EnviroDevelo/cems-platform/README.md

# CEMS Core Platform firmware

Shared firmware platform for the CEMS Supervisor instrument family (STM32H5, FreeRTOS,
lwIP, Riverdi EVE4). It runs the translated Valve Manager / Multiplexor program as a
PLC-style scan and provides the services around it.

- `docs/APP_INTEGRATION.md`: handover for the VM/MUX application build (what to supply, rules, open items)
- `docs/PLATFORM.md`: structure, task priorities, the scan contract, integration rules, decisions needed
- `docs/CUBEMX_SETUP.md`: bringing it up on the STM32H573I-DK in STM32CubeIDE
- `docs/MEMORY.md`: flash and RAM used by each module against the chip's limits (kept current)

## Host builds (Linux/macOS/WSL, gcc)

```
make test      # unit tests (with both FRAM memory maps; includes 400 random power cuts on the log)
make sim       # PC simulation of the demo application
make netsim    # the platform on real sockets: Modbus TCP on 1502, web on https://127.0.0.1:8443/
               # (FRAM and log flash are files: netsim_fram.bin, netsim_nor.bin)
               # (type "remote" / "local" on stdin to act as the touchscreen)
make rtos      # the real FreeRTOS task layer on the FreeRTOS POSIX port (needs EXT=path with FreeRTOS-Kernel)
make target    # compile-check for STM32H5 with arm-none-eabi-gcc (needs EXT, see port/stm32h5/check.mk)
tools/check_target.sh   # compile and link the target in six configurations; updates docs/MEMORY.md
```

Integration tests (with netsim built): `python3 tests/integration/net_test.py` (needs
pymodbus on PYTHONPATH), `python3 tests/integration/fw_test.py` (firmware update and
rollback), `python3 tests/integration/mail_test.py` (alarm email against a test mail
server; needs openssl), `python3 tests/integration/clock_test.py` (clock and SNTP), `python3 tests/integration/serial_test.py` (serial number tokens; needs Python cryptography),
`python3 tests/integration/soak_test.py [minutes]` (soak with memory and socket watch; needs pymodbus) and `python3 tests/integration/web_ui_test.py` (needs Python Playwright and
Chromium).

The application contract (`plat_app_t`) now includes `fw_safe` (may a firmware restart
happen now?) and `alarms`; see `app_demo/`.

Firmware update files: `tools/mkfwimage.py build.bin cems-x.y.z.cfw --version x.y.z`
(add `--key <pem>` to sign; key set-up in `docs/CUBEMX_SETUP.md` 3d).

Touchscreen previews: `UI_DUMP=build/ui ./build/tests` writes each screen's EVE command
list, and `python3 tools/eve_preview.py build/ui/*.eve` renders them to PNG (needs
Pillow). Current screens: `docs/ui/`.

The product build is the STM32CubeIDE project. These host builds are for testing
outside the IDE.
Third-party licences: `docs/THIRD_PARTY.md`. Schematic list and bring-up checks: `docs/HARDWARE.md`.
Screen colours, states, quality marks and wording for every product: `docs/UI_CONVENTIONS.md`.
