EnviroDevelo/cems-platform/docs/CORE_PCB.md

# Core PCB: design specification (draft)

Rev 0.1, 25 Oct 2026. The CEMS main ("core") board: the STM32H5, its memories, the two
Ethernet ports, and the RVT70 touch display plugged straight onto it by FFC (no separate
HMI board). The field I/O is on the separate I/O boards (`PLATFORM.md` 5k) and is not part
of this board. What the firmware needs from the board is in `HARDWARE.md` (H1-H11); this
document turns that into a schematic-ready plan. Items marked **(check)** must be confirmed
against the part's datasheet before layout.

## 1. Block diagram

```
 24 VDC in ─┬─ fuse, reverse-polarity FET, TVS, filter
            └─ buck 24→5 V (1.5 A) ─┬─ 5 V: display backlight (BLVDD, FFC)
                                    └─ buck 5→3.3 V (2 A) ─ MCU, PHY, W5500, memories, display logic

                    ┌──────────────── STM32H573VIT6 (LQFP100) ────────────────┐
 Client RJ45 ═ magnetics ═ LAN8742A ══ RMII ══ ETH MAC   │ lwIP: HTTPS, Modbus TCP, email, SNTP
 I/O RJ45    ═ magnetics ═ W5500 ═══ SPI4 ═══════════════│ I/O bus only (hardware sockets)
 RVT70 display (BT817) ═ 20-pin FFC ═ SPI3 ══════════════│ UI task
 W25Q128JV NOR (event + data log) ═ SPI2 ════════════════│ store task
 MB85RC1MT FRAM 128 KB (settings) ═ I2C1 ════════════════│ store task
 32.768 kHz LSE, CR2032 on VBAT (RTC) ═══════════════════│
 SWD + SWO, BOOT0, reset ════════════════════════════════│
                    └──────────────────────────────────────────────────────────┘
```

## 2. Two separate networks (decided, Gary 25 Oct)

| | Client port (RJ45 1) | I/O port (RJ45 2) |
|---|---|---|
| Purpose | The customer's plant network: PLC, SCADA, web browser, email, time server | Internal link to the I/O boards only |
| Silicon | MCU's own Ethernet MAC on RMII + LAN8742A PHY (as on the DK; firmware driver exists) | WIZnet W5500 (MAC, PHY and TCP/IP in hardware) on its own SPI |
| Stack | lwIP; every network service listens here | W5500 hardware sockets: 3 TCP (one per I/O board) + 1 UDP (discovery, port 50223); nothing listens |
| Addressing | Customer's subnet, DHCP or static | Fixed private subnet set at commissioning |
| MAC address | From the chip UID (D10) | From the chip UID with a different low byte |

No bridging or routing between the two is possible: the I/O traffic never enters lwIP, and
lwIP does not know the I/O port exists. The I/O boards' data reaches the client side only as
the core's own values (platform image → HTTPS and Modbus), never as forwarded packets.

**Hardware hardening of the client port** (security and industrial EMC):
- RJ45 with integrated magnetics (MagJack, Gary 25 Oct) rated 1500 Vrms isolation, Bob Smith
  termination to chassis through 1 nF / 2 kV.
- Low-capacitance ESD array on the PHY side of the magnetics (e.g. TI TPD4E05U06) **(check)**.
- RJ45 shield to the chassis-ground plane, which ties to logic ground only through
  1 MΩ ∥ 4.7 nF / 2 kV near the power input. The two Ethernet ports have separate chassis
  areas at their connectors.
- Nothing else on that connector: no PoE, no debug, no strap that changes the PHY mode.
- The I/O port gets the same protection. Its RJ45 is labelled **I/O ONLY** on the silkscreen
  and the enclosure, and should be a different LED colour or housing so that site
  technicians don't swap the cables. If they do, nothing is exposed: the W5500 has no
  listening sockets and the boards simply don't answer.

**Product lifecycle on the H573:** production units ship with debug closed, so SWD cannot
read the firmware or keys from a unit on site. The state and the recovery route are in
section 13.

## 3. MCU

STM32H573VIT6 (2 MB dual-bank flash, 640 KB RAM, crypto, LQFP100); the STM32H563VIT6 is
pin-compatible if hardware crypto and secure boot aren't wanted (H8). The firmware is
485 KB flash and 438 KB RAM with the application (`MEMORY.md`), so an image fits in one
bank as the bank-swap update needs. LQFP100 gives 82 I/O; this board uses about 45, so there
are spares for later without a bigger package, and it can be hand-reworked on prototypes.

Clocks: HSE crystal 25 MHz on PH0/PH1 (**check** it matches the DK so the CubeMX clock tree
for 250 MHz SYSCLK carries over unchanged); LSE 32.768 kHz on PC14/PC15 with load
capacitors per ST AN2867 (H1). The LAN8742A and the W5500 each have their own 25 MHz crystal, separate from the MCU's HSE (nothing in the MCU clock tree depends on them, and the W5500 SPI clock comes from SPI4). W5500 SPI runs at up to about 30 MHz: keep its traces short (under 50 mm) with a 33 Ω series resistor on SCK and MOSI at the MCU.

## 4. Pin map

Alternate functions are taken from ST's pin data for the STM32H573VI (the same data
CubeMX uses). The SPI, I2C and UART instances are the firmware's defaults where it has one, so
`main.h` needs the fewest overrides.

| Function | Pins (AF) | Firmware name / note |
|---|---|---|
| ETH RMII REF_CLK | PA1 (AF11) | 50 MHz from the LAN8742A (REFCLKO mode) |
| ETH MDIO / MDC | PA2 / PC1 (AF11) | PHY address 0 (strap) |
| ETH CRS_DV | PA7 (AF11) | |
| ETH RXD0 / RXD1 | PC4 / PC5 (AF11) | |
| ETH TX_EN | PA5 (AF11) | |
| ETH TXD0 / TXD1 | PB12 / PB15 (AF11) | |
| PHY nRST | PD11 (GPIO out, initial low → high) | `ETH_PHY_RST` |
| Display SPI3 SCK / MISO / MOSI | PC10 / PC11 / PC12 (AF6) | `hspi3`, the EVE default |
| Display CS | PA15 (GPIO out, initial high) | `EVE_CS` |
| Display PD_N | PD2 (GPIO out, initial high) | `EVE_PD` |
| Display INT_N | PD0 (EXTI0) | `EVE_INT` (routed; the driver polls today). The module has its own 47 kΩ pull-up |
| W5500 SPI4 SCK / MISO / MOSI | PE12 / PE13 / PE14 (AF5) | own bus, not shared (I/O timing) |
| W5500 SCSn | PE11 (GPIO out, initial high) | `W5500_CS` |
| W5500 INTn | PE9 (EXTI9, pull-up) | `W5500_INT` (routed; the driver polls today) |
| W5500 RSTn | PE10 (GPIO out, initial low → high) | `W5500_RST` |
| NOR SPI2 SCK / MISO / MOSI | PB13 / PB14 / PC3 (AF5) | `hspi2`, the NOR default |
| NOR CS | PD10 (GPIO out, initial high) | `NOR_CS`; WP# and HOLD# pulled up |
| FRAM I2C1 SCL / SDA | PB6 / PB7 (AF4) | `hi2c1`, the FRAM default; 2.2 kΩ pull-ups |
| Service UART USART1 TX / RX | PA9 / PA10 (AF7) | 3.3 V header for bench logging |
| SWD SWDIO / SWCLK / SWO | PA13 / PA14 / PB3 | 10-pin 1.27 mm Cortex debug header with NRST |
| BOOT0 | BOOT0 pin | 10 kΩ pull-down, test pad / jumper to 3.3 V (H9) |
| 24 V supply sense | PC0 (ADC1_INP10) | divider 100 k / 10 k; early power-fail warning, supply shown on the System screen |
| Status LEDs | PD12 (run), PD13 (fault) | `DO_01`, `DO_02` (labelled outputs, active high) |
| Hardware revision straps | PE7, PE8 | read once at boot |

Free for later: PA0, PA3, PA4, PA6, PA8, PA11, PA12, PB0-PB2, PB4, PB5, PB8-PB11, PC2,
PC6-PC9, PC13, PD1, PD3-PD7, PD8, PD9, PD14, PD15, PE0, PE2-PE6, PE15.

## 5. Power

| Rail | Source | Loads | Budget |
|---|---|---|---|
| 24 VDC in (18-32 V) | Pluggable terminal (+, 0 V, FE) | | about 0.3 A at 24 V |
| Input protection | Fuse 2 A time-lag (F1), series Schottky SS16 for reverse polarity (D1, 0.15 W at 0.3 A), bidirectional 3 kW TVS SMDJ33CA after it (D2), Y-capacitors to chassis (C16, C17), common-mode choke (L3), 47 µF bulk. Sized for IEC 61326-1 industrial, see `CORE_PCB_EMC.md` | | |
| 5 V | Buck, 60 V rated input: TI TPS54360 (U1, 3.5 A, about 600 kHz, catch diode B260A) | Display backlight BLVDD (FFC pins 17-18): 400 mA at full brightness; the 3.3 V buck about 450 mA | about 0.9 A |
| 3.3 V | Buck from 5 V: TI TLV62569 (U2, 2 A) | MCU about 120 mA, display logic 240 mA max (235 typ; datasheet), W5500 130 mA, LAN8742A 50 mA, NOR, FRAM | about 0.6 A |
| VBAT | CR2032 in a holder (H1) | RTC, backup registers | µA |
| VDDA / VREF+ | 3.3 V through a ferrite and 1 µF + 100 nF | ADC (supply sense) | |

The 60 V input rating is there because the TVS clamps at about 53 V during a surge; a 30 V
buck would not survive one. Display figures are from the RVT70HSBNWC00 V1.1A datasheet Rev 1.1 (27 Jul 2026):
VDD 3.0-3.6 V, 235 mA typ / 240 mA max (audio on at full volume); BLVDD 4.5-5.5 V (5.0 typ;
it still lights from 2.7 V but not at full brightness), 10 / 310 / 400 mA at minimum / 50 % /
100 % backlight. A 5 % 5 V rail is within range; keep the FFC's 5 V drop under 0.25 V. Brown-out: the MCU's BOR at the highest level
plus the supply-sense pin (H10). The core board drives no field outputs (H6 and H7 are on the I/O boards).

## 5a. Hold-up after the 24 V input fails

The firmware needs about 20 ms from the moment the supply crosses 16 V: up to 16 ms to see it
through its 16-sample average, plus finishing the current FRAM or NOR write (firmware thread,
26 Oct). The FRAM store and the log are already safe against a power cut at any byte
(`PLATFORM.md` 4, 5a); the hold-up only stops the last record being lost.

Energy available on the +24 V node between 16 V (detection) and 6 V (where the 5 V buck drops
out; the 3.3 V buck then runs on from the 5 V capacitors a little longer):
`E = ½ × C × (16² − 6²) = 110 × C` joules.

| Load at the moment of failure | Input power | C1 only (49 µF) | With C18 + C19 (1 mF) | Same, cold (-20 % C) |
|---|---|---|---|---|
| Full: backlight 100 %, both networks | about 5.3 W | 1 ms | 20 ms | 16 ms |
| Backlight off on power-fail | about 2.6 W | 2 ms | 42 ms | 34 ms |

So the board carries **two 470 µF 63 V electrolytics (C18, C19)** on the protected +24 V node
(63 V because the TVS clamps near 53 V during a surge), and the fuse goes to **2 A time-lag**
for their charging current at switch-on. **Firmware side (26 Oct):** "failing" trips on two raw readings in a row below 16 V
(2 ms, not the 16 ms average; the average still drives the display and the low/high alarms),
and the UI task turns the backlight off (REG_PWM_DUTY 0) as soon as `plat_power_failing()`
is true. That leaves about 2× margin, even cold.

Everything before 16 V is extra: from 24 V down to 16 V the same capacitors give another
28 ms at full load (`½ × C × (23.6² − 16²)` = 0.15 J), which the firmware doesn't count on.

## 6. Connectors

| Ref | Connector | Notes |
|---|---|---|
| J1 | Power in, 3-way pluggable terminal 5.08 mm | +24 V, 0 V, functional earth to chassis |
| J2 | Client RJ45, shielded, with LEDs | LAN8742A, see section 2 |
| J3 | I/O RJ45, shielded, with LEDs | W5500, labelled I/O ONLY |
| J4 | Display FFC, RiBUS, ZIF 20-pin, 0.5 mm pitch | See section 6a |
| J5 | SWD, 10-pin 1.27 mm Cortex debug | SWDIO, SWCLK, SWO, NRST, 3.3 V, GND |
| J6 | Service UART, 6-pin 2.54 mm (FTDI-cable order) | 3.3 V levels |
| BT1 | CR2032 holder | |
| SW1 | Reset button | |

## 6a. Display FFC (J4), from the RVT70 datasheet

ZIF 20-pin, 0.5 mm pitch. The display's connector is down-side contact; the core board's
connector contact side has to suit the cable the enclosure uses (same-side or opposite-side
FFC) **(check at mechanical layout)**.

| Pin | Display signal | Core board |
|---|---|---|
| 1 | VDD 3.3 V | 3.3 V rail, 10 µF + 100 nF at the connector |
| 2 | GND | GND |
| 3 | SPI_SCLK | PC10 (SPI3_SCK), 33 Ω series at the MCU |
| 4 | MISO / IO.1 | PC11 (SPI3_MISO) |
| 5 | MOSI / IO.0 | PC12 (SPI3_MOSI), 33 Ω series |
| 6 | CS | PA15 (`EVE_CS`) |
| 7 | INT (active low, 47 kΩ pull-up in the module) | PD0 (`EVE_INT`, EXTI0) |
| 8 | RST/PD (active low, 47 kΩ pull-up in the module) | PD2 (`EVE_PD`) |
| 9 | GPIO.0 | test pad, not connected |
| 10 | DISP_AUDIO | test pad, not connected (the module's own 1.5 W amplifier drives a speaker on its P2) |
| 11, 12 | GPIO.1/IO.2, GPIO.2/IO.3 (QSPI data 2, 3) | test pads; single SPI is enough (D24) |
| 13-16 | NC | not connected |
| 17, 18 | BLVDD | 5 V rail, 10 µF + 100 nF at the connector |
| 19, 20 | BLGND | GND |

The display's operating range is -20 to 70 °C (storage -30 to 80 °C): it, not the core
board's -40 to 85 °C parts, sets the instrument's rating.

## 7. Layout notes

- 4 layers: signal / solid ground / power / signal. RMII at 50 MHz and two 100 Ω Ethernet
  pairs need the unbroken ground under them.
- RMII traces short and length-matched (± 5 mm is plenty at 50 MHz), the REF_CLK
  point-to-point with a series resistor at the PHY. Keep RMII away from the SPI buses.
- Under each MagJack: no copper on the line side except chassis; the two ports' chassis
  areas don't touch.
- The W5500's SPI and the display's SPI are on opposite sides of the MCU (PE and PC/PD pins),
  which keeps the high-speed buses apart naturally.
- **Mounting (Gary, 25 Oct): DIN rail, behind the display.** The board sits in a DIN-rail
  enclosure on the rail inside the panel, and the display (179.96 × 119.00 × 13.72 mm,
  without the mounting metal frame) is in the panel door or front, linked by the RiBUS FFC.
  The outline follows the chosen DIN enclosure; the FFC connector goes on the board edge
  that faces the display, with a slot in the enclosure for the cable.
- FFC length: keep it as short as the panel allows, 150 mm or less. RiBUS has only three
  ground pins (2, 19, 20) and no ground between the SPI lines, so a long cable limits the SPI
  clock. The firmware's 30 MHz fast rate is to be proved on the real cable; it can drop to
  15 MHz with no visible effect on the screens. Two BLVDD conductors carry the 400 mA with
  well under 0.1 V drop at that length. If the door has to be further away, a small
  buffer/adapter board at the display is the fallback (not planned).
- Decoupling per ST's hardware getting-started application note for the STM32H5 **(check)**: 100 nF per VDD pin,
  4.7 µF bulk, and the VCAP capacitors at the values the datasheet gives.

## 8. Decisions and open questions

1. **Supply: 24 VDC (Gary, 25 Oct)**, 18-32 V range, the same as the I/O boards' field supply.
2. **Mounting: DIN rail, behind the display (Gary, 25 Oct)**; see section 7.
3. **No system-OK relay (Gary, 25 Oct):** the PLC's Modbus communication watchdog is
   enough to detect a core board that has stopped.
4. **No RS-485 on the core board (Gary, 25 Oct):** the second RJ45 replaces it. The
   firmware's RS-485 I/O link setting has no port on this board (`bsp_rs485()` returns NULL).
5. **Ethernet: RJ45s with integrated magnetics (Gary, 25 Oct)**, shielded, with LEDs,
   1500 Vrms, -40 to 85 °C.
6. **Enclosure (chosen 25 Oct, Gary can override):** see section 10.

## 9. BOM summary (main parts)

| Part | Function | Qty |
|---|---|---|
| STM32H573VIT6 (or H563VIT6) | MCU | 1 |
| LAN8742A-CZ-TR (-40 to 85 °C) | Client Ethernet PHY | 1 |
| W5500 (-40 to 85 °C) | I/O Ethernet controller | 1 |
| Würth 7499010121A (RJ45 with magnetics and LEDs) | J2, J3 | 2 |
| MB85RC1MT | 128 KB FRAM, settings | 1 |
| W25Q128JV | 16 MB NOR, event and data log | 1 |
| 25 MHz crystals | MCU HSE, PHY, W5500 | 3 |
| 32.768 kHz crystal | RTC | 1 |
| TPS54360DDA (60 V in, 3.5 A) | 24 → 5 V buck | 1 |
| TLV62569DBV | 5 → 3.3 V buck | 1 |
| SS16, SMDJ33CA, 2 A T fuse, Würth 744227 choke | Input protection | 1 each |
| 470 µF 63 V radial 12.5 mm, 105 °C | Hold-up (C18, C19) | 2 |
| TPD4E05U06 (or equal) | Ethernet ESD | 2 |
| Hirose FH12-20S-0.5SH(55) | Display FFC | 1 |
| CR2032 holder | VBAT | 1 |

## 10. Enclosure

The board goes in a DIN-rail electronics housing on the panel's rail. The two RJ45s, the
24 V terminal and the display's FFC exit all need openings, and the board has no field
wiring other than power. Shortlist:

| Housing | For | Against |
|---|---|---|
| **Phoenix Contact BC 107,6 (6 modules, 107.6 mm wide)**, chosen | Made for electronics boards: PCB guides at two levels, top covers for pluggable terminals and RJ45 openings, IP20 for a panel, widely stocked | Openings beyond the standard covers need machining |
| Camdenboss CNMB/6 (6 modules) | Low cost, quick to get | Plain covers: every RJ45 and the FFC slot must be machined |
| Phoenix Contact ICS 50 | Designed for front RJ45s and bus connectors | Dearer, larger than this board needs |

The board outline, the connector positions and the FFC exit follow the BC 107,6 PCB drawing.
**(check: the drawing could not be downloaded from here, so the outline is set at layout from
Phoenix Contact's data.)** The schematic doesn't depend on the enclosure.

## 11. Schematic

`hardware/core_pcb/` holds the KiCad 7 project: a root sheet and five sheets (power, MCU,
client Ethernet, I/O Ethernet, memories and display), 145 parts, and a PDF of all sheets
(`cems_core.pdf`) for review without KiCad. The schematic is generated from
`hardware/core_pcb/tools/design.py`, the single description of the circuit, by
`gen_schematic.py`. Each connected pin carries a net label and each unused pin a no-connect
flag. `check_netlist.py` then checks KiCad's own exported netlist against `design.py`, pin by
pin, along with each part's footprint and value. `bom.csv` is the grouped bill of materials.
Values marked CHECK in the sheet notes (buck compensation, crystal load capacitors, the
Ethernet line terminations, the FRAM pinout, the FFC contact side) must be confirmed against
their datasheets before layout.

## 12. What the firmware reads from the board (CIP-01.3, CIP-07.3)

**Hardware revision straps, PE7 and PE8.** Read once at boot, as inputs with the internal
pull-ups and pull-downs off; each pin has a 10 kΩ to ground (R23, R24) and a 10 kΩ to 3.3 V
footprint (R25, R26), and a revision fits one or the other.

| PE8 | PE7 | `hw_rev` | Board |
|---|---|---|---|
| 0 | 0 | 0 | Rev A (this design, rev 0.1 schematic) |
| 0 | 1 | 1 | Rev B |
| 1 | 0 | 2 | Rev C |
| 1 | 1 | 3 | Rev D |

`hw_rev = (PE8 << 1) | PE7`. The firmware reports it with the firmware version (`/api/info`,
System screen) and can refuse an image built for another revision. A fifth revision needs a
third strap (PE15 is free and next to them).

**24 V supply sense, PC0 (ADC1_INP10).** R9 100 kΩ over R10 8.2 kΩ, both 1 %, with C13 100 nF:

- `V24 = V_PC0 × (100 + 8.2) / 8.2 = 13.20 × V_PC0`. With the 12-bit ADC and VREF+ = VDDA:
  `V24 = raw × VDDA / 4095 × 13.20`. Take VDDA from the VREFINT calibration value
  (VDDA = 3.3 V × VREFINT_CAL / VREFINT reading), not the nominal 3.3 V, since the 3.3 V rail
  is only ±2 %.
- Full scale is 43.5 V; 24 V reads about 1.82 V (raw about 2260).
- The sense point is after the reverse-polarity diode D1, so it reads about 0.4 V below the
  terminal voltage at full load. Add 0.4 V for display, or report "supply (after protection)".
- Accuracy: about ±3 % with VREFINT correction (resistor tolerances and the ADC).
- Source impedance 7.6 kΩ, but C13 holds the node, so any sampling time works. The node's
  time constant is 0.76 ms: average 16 samples per reading; it is a supervision value, not a
  fast one.
- Suggested thresholds: below 19 V supply low (warning); below 16 V supply failing (log it
  and stop writes that are not power-safe); above 30 V supply high. The bucks run down to
  about 6 V at the input, so the board keeps working through the whole range.
- A surge can briefly lift PC0 to about 4 V; the 100 kΩ limits the injected current to well
  under the pin's 5 mA. Readings in the 100 µs after such an event are not trusted (the
  average covers it).

## 13. Debug lock and recovery (agreed with the firmware thread, 26 Oct; CIP-04.4, CIP-20.4)

Based on ST's STM32H5 product-state model (RM0481 "product life cycle" and debug
authentication). **(check: confirm the state names and what each regression erases in
RM0481 before the first production unit is closed.)**

| Stage | Product state | Debug | Recovery |
|---|---|---|---|
| Development, bench, DK | Open | Full SWD | SWD (J5), BOOT0 jumper (JP1) for the ST bootloader |
| Production units | **Closed, with debug authentication provisioned** | Off: SWD can't read flash, RAM or keys | Authorised regression over SWD (below) |
| Not used | Locked | Off for good | None: a unit with both banks bad would be scrap |

- **Normal updates never need SWD:** the network update writes the free bank, test-boots it
  and rolls back by itself (`PLATFORM.md` 5b). Recovery is only for a unit whose both
  banks are unusable, which the update design prevents.
- **Recovery route:** a technician with the company's debug-authentication credential
  (certificate on the H573; a password on the H563) opens the housing, connects J5, and runs
  a regression with ST's tools. That erases the user flash and returns the chip to Open; the
  factory image is then programmed and the unit closed again. FRAM and the NOR log are
  separate chips and are kept. The serial number (D25), hw_rev, calibration, every setting
  and the HTTPS key all live in FRAM (firmware thread, 26 Oct), so the unit keeps its
  identity and certificate fingerprint and needs no developer token afterwards.
- **Confirmed by the firmware thread (26 Oct)**, with one bench check: the network update
  flips SWAP_BANK from the application, which the H5 allows when Closed. The first Closed DK
  must show an update and a rollback working. Secure boot will keep this route, with no
  Locked state.
- **Hardware for this:** J5 (SWD with NRST) fitted on every unit, inside the housing, not
  reachable without opening it; JP1 BOOT0 footprint fitted, no jumper in production (the
  bootloader is not a route on a closed unit); BOOT0 pulled down by R20.
- The credential is held like the firmware signing key: not in the repository, two people
  hold it.
