EnviroDevelo/cems-platform/docs/MEMORY.md

# Memory budget (decision D18)

Generated by `tools/mem_report.py` from the linker map of the fullest target build
(I2C FRAM, SPI NOR log flash, EVE display, lwIP, every service). Re-run it after every
module, and before choosing hardware. Last run: 2026-10-22.

## Totals

| Resource | Used | Limit | Used % | Free |
|---|---|---|---|---|
| Flash (one bank: the image limit with dual-bank updates) | 391.1 KB | 1016.0 KB | 38 % | 624.9 KB |
| RAM (STM32H573/H563, 640 KB) | 391.7 KB | 640.0 KB | 61 % | 248.3 KB |

## By module (KB)

| Module | Flash | RAM |
|---|---|---|
| Scan engine, queue, watchdog, diag | 18.9 | 0.1 |
| Parameter table | 9.4 | 25.7 |
| Parameter store (FRAM) | 5.3 | 57.2 |
| Event log / data logger | 14.5 | 6.8 |
| Alarm manager | 4.9 | 2.9 |
| Alarm email (SMTP client) | 6.2 | 2.2 |
| Clock + SNTP | 1.7 | 0.1 |
| Firmware update, signatures, serial | 6.0 | 1.6 |
| I/O boards (RS-485 master) | 6.5 | 0.4 |
| Modbus TCP | 6.0 | 17.5 |
| Web server + page + logins | 41.9 | 72.9 |
| HTTPS (tls.c + mbedTLS) | 96.3 | 46.9 |
| Touch UI + EVE driver | 52.1 | 2.5 |
| Task layer (FreeRTOS glue) | 2.6 | 54.8 |
| Board support (BSP) | 0.9 | 0.7 |
| lwIP + Ethernet driver | 54.4 | 48.5 |
| FreeRTOS kernel + heap | 10.0 | 48.8 |
| ST HAL + startup | 21.2 | 0.0 |
| Application | 2.1 | 0.2 |
| C library | 27.6 | 0.8 |
| Other | 2.5 | 0.0 |
| Main stack (interrupts, start-up) | 0.0 | 1.0 |

## With the VM/MUX application (app_vmmux)

The same build with the real application linked in (`make target APP=...`).

| Resource | Used | Limit | Used % | Free |
|---|---|---|---|---|
| Flash | 485.3 KB | 1016.0 KB | 48 % | 530.7 KB |
| RAM | 438.2 KB | 640.0 KB | 68 % | 201.8 KB |

The application itself: 83.5 KB of flash, 46.1 KB of RAM (its tags, timers and tables).

RAM includes every task stack (inside "Task layer"), the FreeRTOS heap (48 KB, in
"FreeRTOS kernel + heap", used by lwIP), and TLS's own fixed 44 KB pool (inside "HTTPS"),
shared by the web server and the alarm-email client one at a time: measured peaks 28 KB
(web), 32 KB (mail server with an RSA-2048 key), 38 KB (RSA-4096). Alarm email added
about 31 KB of flash (TLS client, RSA, SHA-384/512 for the server's certificate, SMTP) and
11 KB of RAM (the larger pool, the client context and buffers). The 128 KB FRAM map (D6)
added about 60 KB of RAM: the store's working copy of a 40 KB settings slot and the web
server's buffer, which holds a whole backup file for restore.

## Still to come (estimates, update when built)

| Item | Flash | RAM | Note |
|---|---|---|---|
| Application alarm table (the ~50 alarms of 70_alarm_map) | ~2.5 | 0 | 24 bytes of constants each; RAM per alarm is already reserved (96 slots) |

## Other non-volatile memory

| Store | Size | Used | Note |
|---|---|---|---|
| FRAM (MB85RC1MT, 128 KB; D6, Gary 20 Oct) | 128 KB | user image: the VM/MUX application's 13.4 KB including the platform settings, of 40 KB per copy (34 %); factory 4 KB; log pointer, boot record, HTTPS key record and firmware update history 848 B | the 32 KB breakout (MB85RC256V) still fits the application (90 % per copy) with PLAT_FRAM_SIZE=32768u; the driver refuses a part smaller than the build's map |
| Log flash (W25Q128, 16 MB) | 16 MB | ring buffer, always "full" by design | events ~16,000; data 45 days at 10 channels / 60 s |
