EnviroDevelo/cems-platform/docs/web_alarm_actions.png

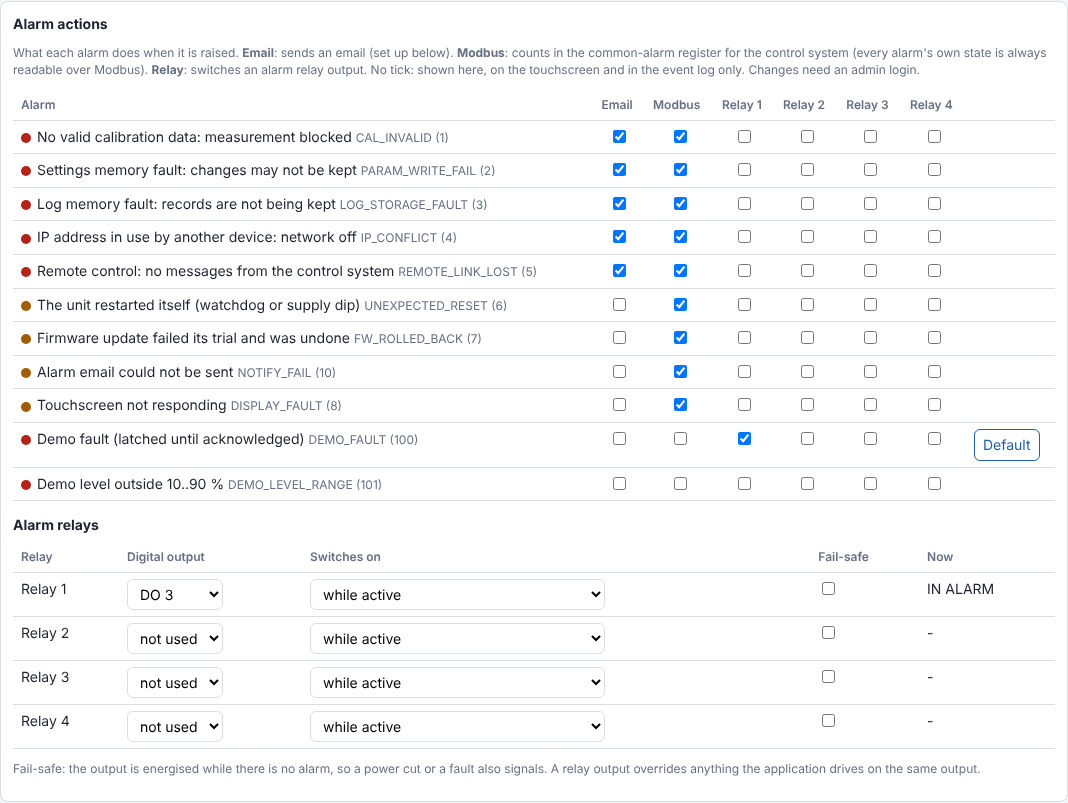
docs/web_alarm_actions.png
