EnviroDevelo/cems-platform/docs/web_clock.png

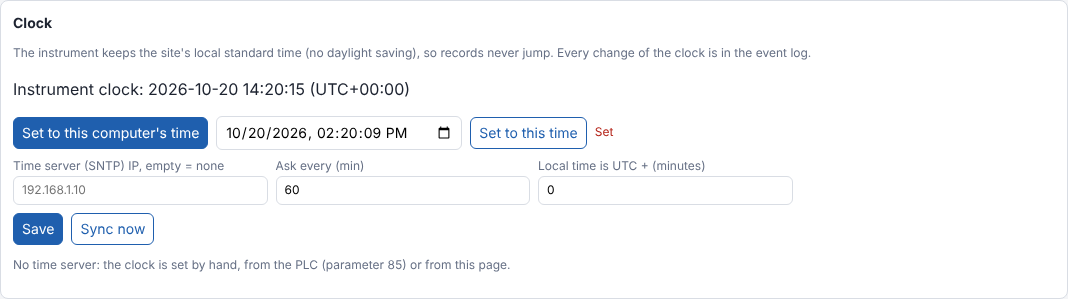
docs/web_clock.png
