EnviroDevelo/cems-platform/docs/web_firmware.png

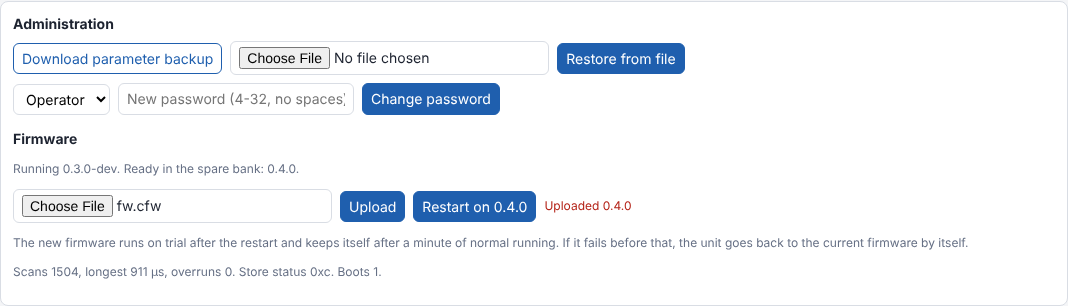
docs/web_firmware.png
