EnviroDevelo/cems-platform/docs/web_iob.png

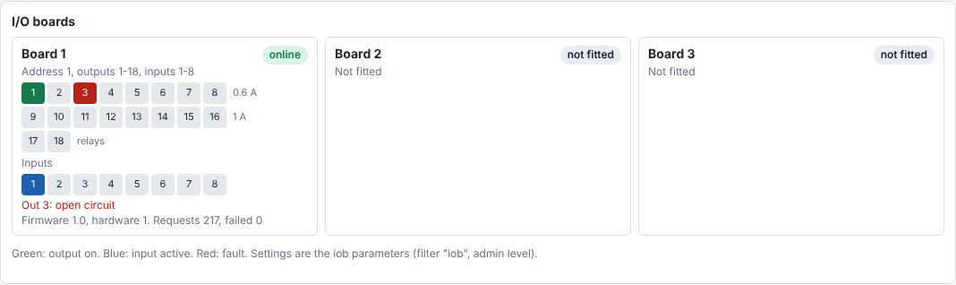
docs/web_iob.png
