EnviroDevelo/cems-platform/docs/web_mail.png

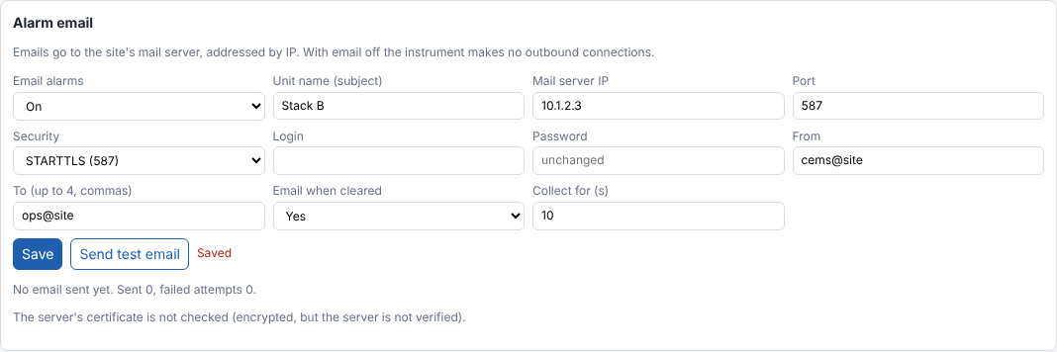
docs/web_mail.png
