EnviroDevelo/cems-platform/docs/web_ui.png

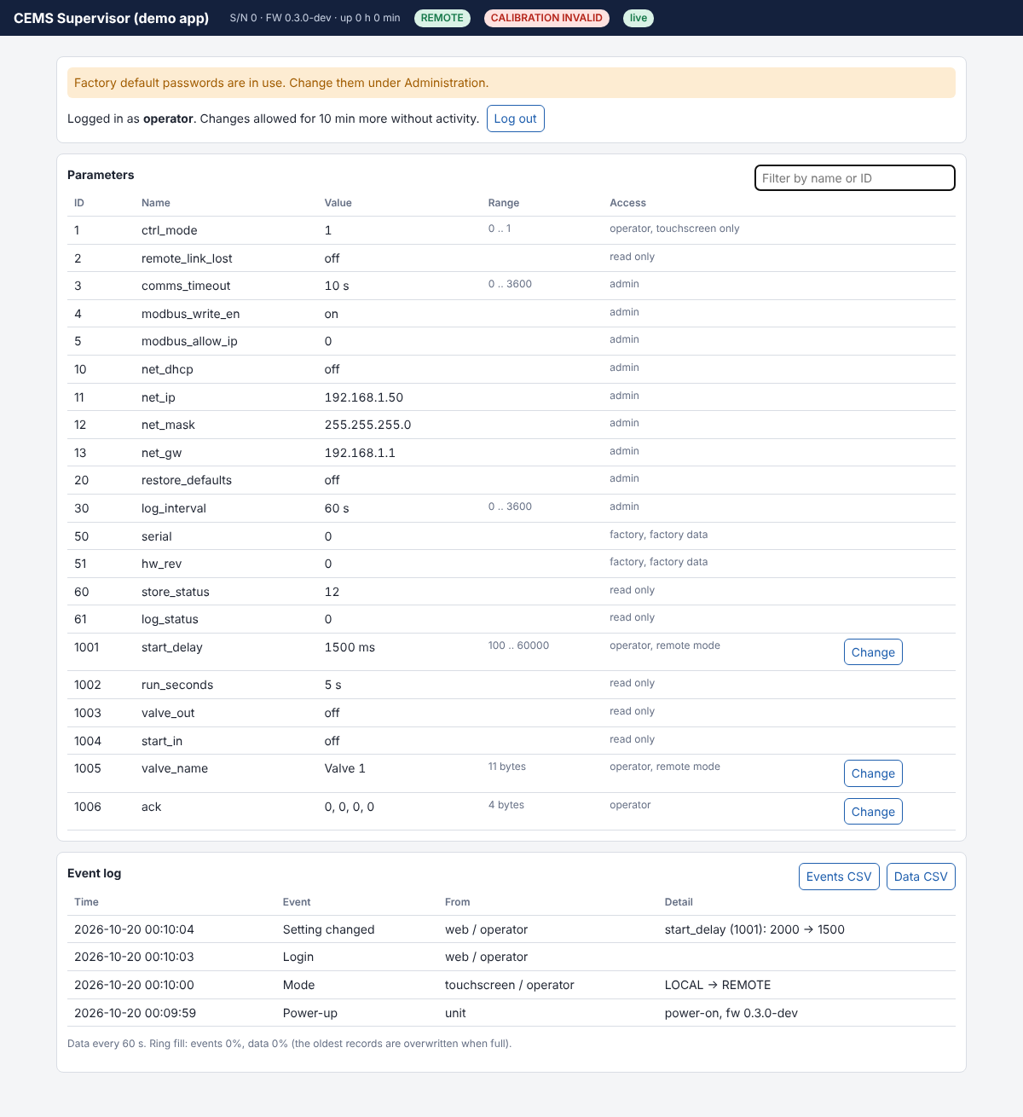
docs/web_ui.png
