EnviroDevelo/cems-platform/docs/web_ui_connection_lost.png

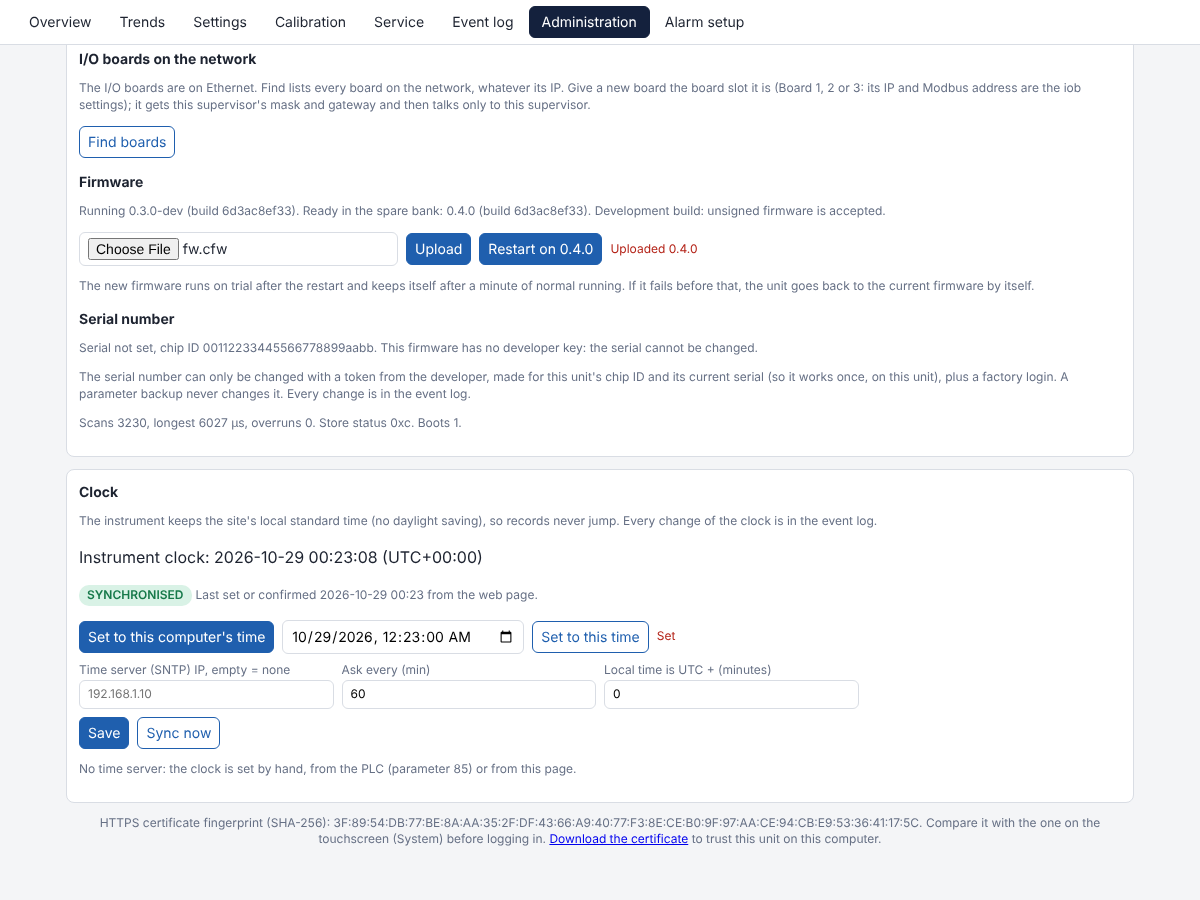
docs/web_ui_connection_lost.png
