EnviroDevelo/cems-platform/docs/web_iob_commission.png

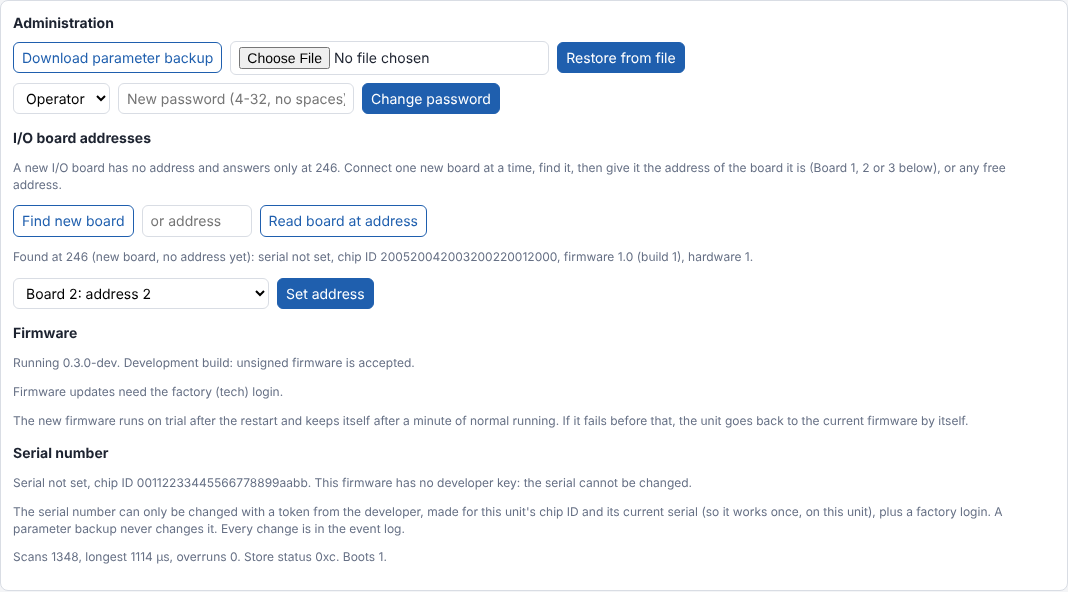
docs/web_iob_commission.png
