EnviroDevelo/cems-platform/hardware/core_pcb/power.kicad_sch

## KiCad design hardware/core_pcb/power.kicad_sch (2026-10-26)

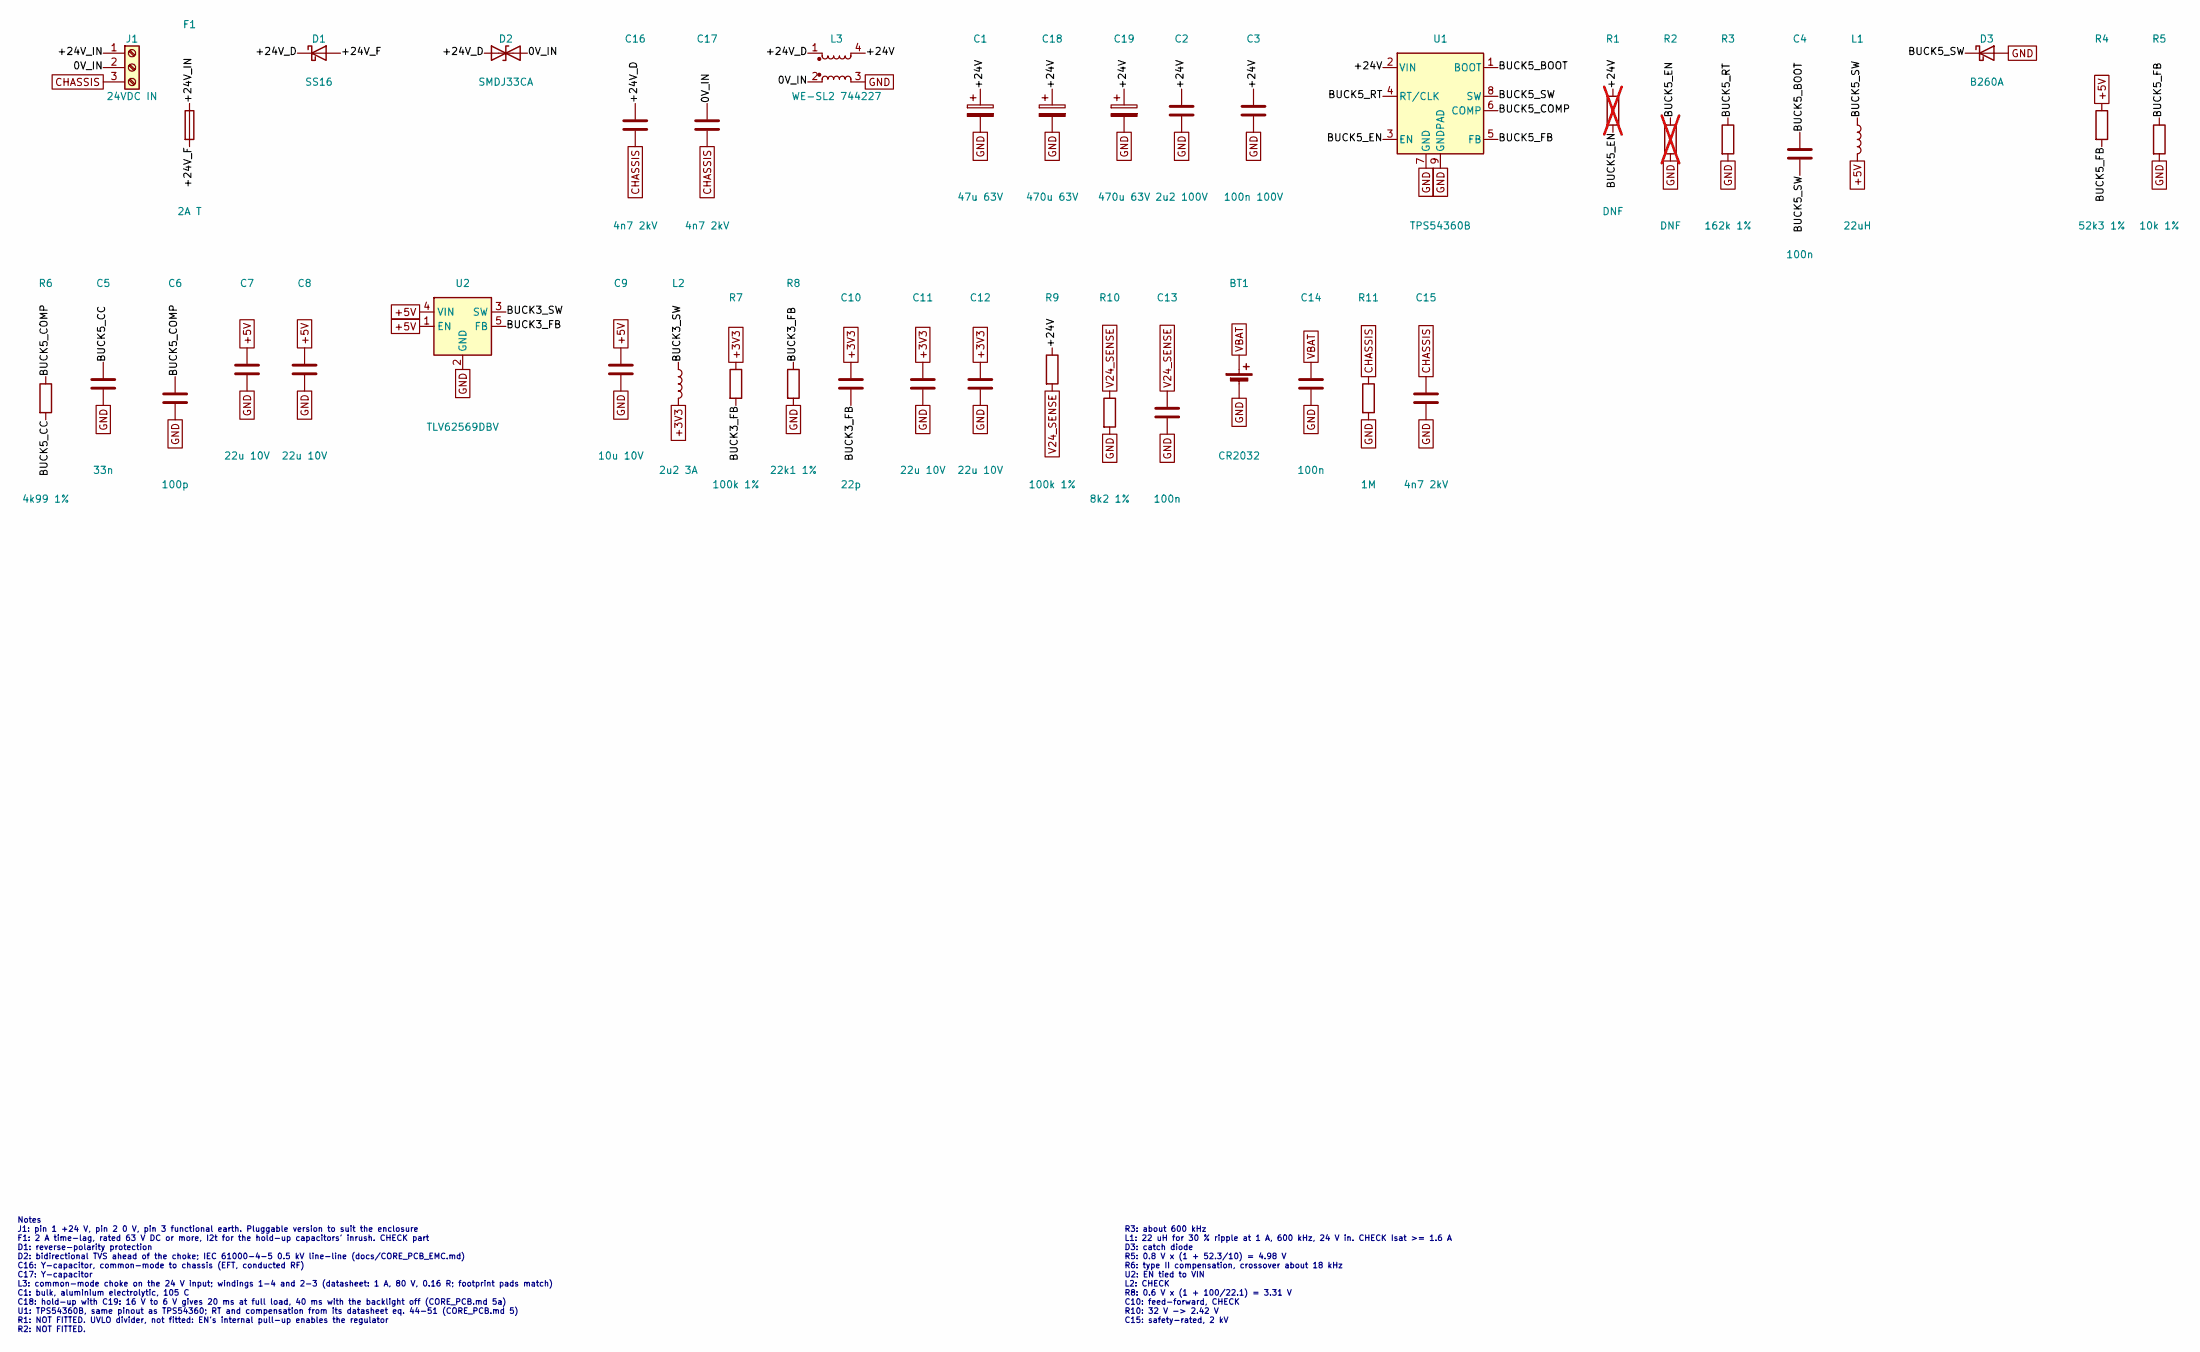
[picture p9: schematic power.kicad_sch]

Parts:
BT1: CR2032; BatteryHolder_Keystone_3034_1x20mm; MPN Keystone 3034 holder + CR2032
C1: 47u 63V; CP_Elec_8x10; MPN 47u 63V
C2: 2u2 100V; C_1210_3225Metric; MPN 2u2 100V
C3: 100n 100V; C_0603_1608Metric; MPN 100n 100V
C4, C13, C14: 100n; C_0603_1608Metric; MPN 100n
C5: 33n; C_0603_1608Metric; MPN 33n
C6: 100p; C_0603_1608Metric; MPN 100p
C7, C8: 22u 10V; C_1210_3225Metric; MPN 22u 10V
C9: 10u 10V; C_0805_2012Metric; MPN 10u 10V
C10: 22p; C_0603_1608Metric; MPN 22p
C11, C12: 22u 10V; C_1206_3216Metric; MPN 22u 10V
C15, C16, C17: 4n7 2kV; C_1812_4532Metric; MPN 4n7 2kV
C18, C19: 470u 63V; CP_Radial_D12.5mm_P5.00mm; MPN 470 uF 63 V, 105 C, low ESR, 12.5 mm ra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
D1: SS16; D_SMA; MPN SS16 (60 V, 1 A)
D2: SMDJ33CA; D_SMC; MPN SMDJ33CA (3 kW)
D3: B260A; D_SMA; MPN B260A-13 (60 V, 2 A)
F1: 2A T; Fuse_1206_3216Metric; MPN 2A T
J1: 24VDC IN; TerminalBlock_Phoenix_MKDS-1,5-3-5.08_1x03_P5.08mm_Horizont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; MPN 24VDC IN
L1: 22uH; L_Bourns_SRN6045TA; MPN Bourns SRN6045TA-220M
L2: 2u2 3A; L_Wuerth_MAPI-4030; MPN Wurth 74438357022 (MAPI 4030, 2.2 uH)
L3: WE-SL2 744227; L_CommonMode_Wuerth_WE-SL2; MPN Wurth 744227
R1, R2: DNF; R_0603_1608Metric; MPN DNF; not fitted
R3: 162k 1%; R_0603_1608Metric; MPN 162k 1%
R4: 52k3 1%; R_0603_1608Metric; MPN 52k3 1%
R5: 10k 1%; R_0603_1608Metric; MPN 10k 1%
R6: 4k99 1%; R_0603_1608Metric; MPN 4k99 1%
R7, R9: 100k 1%; R_0603_1608Metric; MPN 100k 1%
R8: 22k1 1%; R_0603_1608Metric; MPN 22k1 1%
R10: 8k2 1%; R_0603_1608Metric; MPN 8k2 1%
R11: 1M; R_1206_3216Metric; MPN 1M
U1: TPS54360B; TI_SO-PowerPAD-8_ThermalVias; MPN TPS54360BDDAR
U2: TLV62569DBV; SOT-23-5; MPN TLV62569DBVR

Connections:
0V_IN: C17.1, D2.2 (A2), J1.2, L3.2
+3V3: C10.1, C11.1, C12.1, L2.2, R7.1
+5V: C7.1, C8.1, C9.1, L1.2, R4.1, U2.1 (EN), U2.4 (VIN)
+24V: C1.1, C2.1, C3.1, C18.1, C19.1, L3.4, R1.1, R9.1, U1.2 (VIN)
+24V_D: C16.1, D1.1 (K), D2.1 (A1), L3.1
+24V_F: D1.2 (A), F1.2
+24V_IN: F1.1, J1.1
BUCK3_FB: C10.2, R7.2, R8.1, U2.5 (FB)
BUCK3_SW: L2.1, U2.3 (SW)
BUCK5_BOOT: C4.1, U1.1 (BOOT)
BUCK5_CC: C5.1, R6.2
BUCK5_COMP: C6.1, R6.1, U1.6 (COMP)
BUCK5_EN: R1.2, R2.1, U1.3 (EN)
BUCK5_FB: R4.2, R5.1, U1.5 (FB)
BUCK5_RT: R3.1, U1.4 (RT/CLK)
BUCK5_SW: C4.2, D3.1 (K), L1.1, U1.8 (SW)
CHASSIS: C15.1, C16.2, C17.2, J1.3, R11.1
GND: BT1.2 (-), C1.2, C2.2, C3.2, C5.2, C6.2, C7.2, C8.2, C9.2, C11.2, C12.2, C13.2, C14.2, C15.2, C18.2, C19.2, D3.2 (A), L3.3, R2.2, R3.2, R5.2, R8.2, R10.2, R11.2, U1.7 (GND), U1.9 (GNDPAD), U2.2 (GND)
V24_SENSE: C13.1, R9.2, R10.1
VBAT: BT1.1 (+), C14.1

Notes on the sheet:
Notes J1: pin 1 +24 V, pin 2 0 V, pin 3 functional earth. Pluggable version to suit the enclosure F1: 2 A time-lag, rated 63 V DC or more, I2t for the hold-up capacitors' inrush. CHECK part D1: reverse-polarity protection D2: bidirectional TVS ahead of the choke; IEC 61000-4-5 0.5 kV line-line (doc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
R3: about 600 kHz L1: 22 uH for 30 % ripple at 1 A, 600 kHz, 24 V in. CHECK Isat >= 1.6 A D3: catch diode R5: 0.8 V x (1 + 52.3/10) = 4.98 V R6: type II compensation, crossover about 18 kHz U2: EN tied to VIN L2: CHECK R8: 0.6 V x (1 + 100/22.1) = 3.31 V C10: feed-forward, CHECK R10: 32 V -> 2.42 V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
