EnviroDevelo/cems-platform/platform/include/plat_alarm.h

/* plat_alarm.h - the alarm manager (design spec "Alarms"; Analysis 70_Alarms_Logging
 * section 8, findings K1-K12).
 *
 * One table of alarm definitions and one state per alarm. Producers only report a
 * condition; the manager owns the delays, the latch, the acknowledge and the state,
 * so the old program's two layers (source bits plus the panel's own alarm table,
 * whose texts drifted onto the wrong alarms: K1, K2) become one.
 *
 * IDs: 1..99 platform (ALARM_ID_* below), 100..255 application.
 *
 * States (ISA-18.2 style):
 *   normal            condition absent, nothing to acknowledge
 *   active, unacked   condition present (after the on-delay), not yet acknowledged
 *   active, acked     condition present, acknowledged
 *   cleared, unacked  condition gone (after the off-delay) before anyone acknowledged:
 *                     stays in the list until acknowledged, so a short alarm is not missed
 * AL_LATCH: an active alarm stays active after its condition goes until acknowledged
 *   (the old FlowValidationAlarm). AL_NO_ACK: a status alarm, shown while active,
 *   never waits for an acknowledge (digital stop, analyser not OK: K8).
 * Acknowledge never changes a condition, never clears a source and never re-sends
 * anything (K7, N3): it only moves the alarm's state. One alarm by ID, or all.
 *
 * Every raise, clear and acknowledge goes to the event log with the source and login
 * level (K11, K12). Optional per-alarm parameters: an enable (false suppresses the
 * alarm, e.g. a range alarm switched off; retained, so it survives a power cut: K4),
 * an editable description (stored with the settings, so it cannot land on another
 * alarm: K1, K2) and an on-delay in seconds (valve feedback settling time: N11).
 *
 * Threading
 *   alarm_set(), alarm_set_range()   any task (a byte store); normally the scan logic
 *   alarm_scan()                     scan task, once per scan (plat_sys pre_logic)
 *   alarm_ack()                      scan task (param_apply calls it for PARAM_ID_ALARM_ACK);
 *                                    other tasks post that parameter instead
 *   alarm_list(), alarm_summary(),
 *   alarm_get()                      any task: a consistent copy
 */
#ifndef PLAT_ALARM_H
#define PLAT_ALARM_H
#include <stdint.h>
#include <stdbool.h>
#include <stddef.h>
#include "plat_io.h"

#ifndef PLAT_ALARM_MAX
#define PLAT_ALARM_MAX 96u           /* platform + application definitions */
#endif
#define ALARM_ID_MAX      255u
#define ALARM_ID_APP_FIRST 100u
#define ALARM_ACK_ALL     0xFFFFu    /* PARAM_ID_ALARM_ACK value: acknowledge every alarm */
#define ALARM_BIT_WORDS   16u        /* PARAM_ID_ALARM_*_BITS: bit (id % 16) of word (id / 16) */

/* severities: the colour in the lists and the header */
enum { AL_SEV_STATUS = 0, AL_SEV_WARNING = 1, AL_SEV_ALARM = 2, AL_SEV_FAULT = 3 };

/* Actions (routes), per alarm. Each alarm has a default in its definition; the user
 * changes it with parameter 46 (one byte per alarm ID): bit 7 set = configured (bits
 * 0..6 apply), bit 7 clear = use the definition's default. 0x80 = do nothing. */
#define AR_EMAIL    0x01u   /* send an email (raise; clear too if mail_on_clear) */
#define AR_MODBUS   0x02u   /* counted in the Modbus common-alarm word (parameter 45) */
#define AR_RELAY(k) ((uint8_t)(0x04u << (k)))   /* drive alarm relay k (0..3) */
#define AR_SET      0x80u
#define ALARM_RELAYS 4u
/* relay modes (parameter 48) */
enum { AR_MODE_ACTIVE = 0,      /* on while any routed alarm is active */
       AR_MODE_UNACKED = 1,     /* on while any routed alarm waits for an acknowledge (a horn: ack silences it) */
       AR_MODE_ACTIVE_OR_UNACKED = 2 };  /* on until every routed alarm is both cleared and acknowledged (a lamp) */
/* parameter 45 bits */
#define ACOM_MB_ACTIVE   0x0001u  /* a Modbus-routed alarm is active */
#define ACOM_MB_UNACKED  0x0002u  /* a Modbus-routed alarm waits for an acknowledge */
#define ACOM_ANY_ACTIVE  0x0004u
#define ACOM_ANY_UNACKED 0x0008u
#define ACOM_RELAY(k)    ((uint16_t)(0x0100u << (k)))   /* relay k is in alarm (before inversion) */

/* flags */
#define AL_LATCH   0x01u   /* stays active until acknowledged, even if the condition goes */
#define AL_NO_ACK  0x02u   /* status alarm: no acknowledge, leaves the list when it clears */
#define AL_NOTIFY  0x04u   /* passed to alarm_on_change (notification: email, relay; Stage 8) */

typedef struct {
    uint16_t    id;            /* 1..99 platform, 100..255 application */
    uint8_t     severity;      /* AL_SEV_* */
    uint8_t     flags;         /* AL_* */
    uint32_t    on_delay_ms;   /* condition must last this long to raise (0 = at once) */
    uint32_t    off_delay_ms;  /* and be gone this long to clear */
    const char *name;          /* event log and JSON key: [A-Z0-9_], up to 22 characters */
    const char *text;          /* description shown when no text parameter is given */
    uint16_t    text_param;    /* PT_TEXT / PT_TEXT16 parameter with an editable description (0 = none) */
    uint16_t    enable_param;  /* bool parameter: false suppresses the alarm (0 = always enabled) */
    uint16_t    delay_param;   /* integer parameter, s: replaces on_delay_ms (0 = none) */
    uint8_t     route;         /* default actions: AR_EMAIL | AR_MODBUS | AR_RELAY(k) (0 = none) */
} alarm_def_t;

/* ---------------- platform alarms ---------------- */
enum {
    ALARM_ID_CAL_INVALID       = 1,   /* no valid factory (calibration) data: measurement blocked */
    ALARM_ID_PARAM_WRITE_FAIL  = 2,   /* settings could not be written to the FRAM */
    ALARM_ID_LOG_STORAGE_FAULT = 3,   /* log flash erase/write/read-back failed */
    ALARM_ID_IP_CONFLICT       = 4,   /* another device answers at our static IP address */
    ALARM_ID_REMOTE_LINK_LOST  = 5,   /* remote control and no remote traffic for the timeout */
    ALARM_ID_UNEXPECTED_RESET  = 6,   /* the watchdog or a brown-out restarted the unit */
    ALARM_ID_FW_ROLLED_BACK    = 7,   /* a firmware update failed its trial and was undone */
    ALARM_ID_DISPLAY_FAULT     = 8,   /* the touchscreen stopped responding */
    ALARM_ID_NOTIFY_FAIL       = 10,  /* an alarm email could not be sent (after retries) */
    ALARM_ID_RESOURCE_LOW      = 11,  /* memory running low (plat_health.h) */
    ALARM_ID_IOB_LOST          = 12,  /* an enabled I/O board does not answer on RS-485 (iobus.h) */
    ALARM_ID_IOB_CONFIG        = 13,  /* an I/O board is the wrong type, or its channel settings conflict */
    ALARM_ID_IOB_OUT_FAULT     = 14,  /* an I/O board output: open circuit, short, overheating, no field supply */
    ALARM_ID_IOB_IN_FAULT      = 15,  /* an I/O board input: wire break or input chip fault */
    ALARM_ID_IOB_SUPPLY        = 16,  /* an I/O board's field 24 V supply is missing */
    ALARM_ID_IOB_NODE_RESET    = 17,  /* an I/O board was restarted by its watchdog */
    ALARM_ID_IOB_TEMP_FAULT    = 18,  /* an I/O board temperature input: open, short, out of range, converter fault */
};

/* A copy of one alarm, for lists. */
typedef struct {
    uint16_t id;
    uint8_t  severity, flags;
    bool     active, unacked, cond, enabled;
    uint32_t t_raise;          /* s since 1970 when raised (0 if the clock was not set) */
    uint32_t up_raise;         /* uptime s when raised */
    const char *name;
    char     text[64];         /* the description (UTF-8) */
} alarm_view_t;

typedef struct {
    uint16_t active;           /* alarms active (including acknowledged ones) */
    uint16_t unacked;          /* alarms waiting for an acknowledge (active or cleared) */
    uint16_t shown;            /* entries in the list: active or unacked */
    int8_t   worst;            /* highest severity among the shown entries, -1 if none */
    bool     worst_unacked;    /* that severity has an unacknowledged entry */
} alarm_summary_t;

/* Build the table from the platform alarms plus the application's. Returns 0, or
 * the first bad ID (duplicate, 0, > 255, an application ID below 100, a missing
 * parameter or a full table). reset_cause (bsp_reset_cause_t) raises
 * UNEXPECTED_RESET after a watchdog or brown-out reset. Call after param_init. */
int  alarm_init(const alarm_def_t *app_defs, size_t n_app, uint8_t reset_cause);

/* Producers. Unknown IDs are ignored. alarm_set_range: the condition is "value
 * outside lo..hi"; once raised it stays until the value is back inside by the
 * deadband (no chatter on a limit: K5). NaN keeps the previous condition. */
void alarm_set(uint16_t id, bool cond);
void alarm_set_range(uint16_t id, float value, float lo, float hi, float deadband);

void alarm_scan(uint32_t now_ms);     /* scan task: platform conditions, delays, states, events */
void alarm_io_out(plat_io_out_t *out); /* scan task, after the application's outputs: the alarm relays */
uint8_t alarm_route(uint16_t id);     /* the actions in force for an alarm (AR_* without AR_SET) */
uint8_t alarm_relays(void);           /* bit k = relay k in alarm (before inversion) */

/* Email (mail.c provides it; weak no-op otherwise): one alarm transition to send. */
void plat_alarm_email(const alarm_def_t *d, uint8_t what, uint32_t t_unix, uint32_t up_s);

/* Acknowledge one alarm or ALARM_ACK_ALL. 0 done (or nothing to acknowledge),
 * -1 unknown ID. Scan task (via PARAM_ID_ALARM_ACK). */
int  alarm_ack(uint16_t id, uint8_t src, uint8_t level);

/* Readers (any task). The entries that are active or unacked, most urgent first
 * (unacked active, then acked active, then cleared unacked; higher severity first;
 * newest first). alarm_next walks them one at a time (start with *pos = 0; false at
 * the end); alarm_list copies up to max after skipping skip (a page). */
bool   alarm_next(uint64_t *pos, alarm_view_t *out);
size_t alarm_list(alarm_view_t *out, size_t skip, size_t max);
bool   alarm_get(uint16_t id, alarm_view_t *out);
void   alarm_summary(alarm_summary_t *s);
bool   alarm_active(uint16_t id);          /* e.g. to mark a logged value FLAG */
size_t alarm_count(void);                  /* definitions */
const alarm_def_t *alarm_def_at(size_t i);
const char *alarm_sev_name(uint8_t sev);

/* Notification hook (Stage 8: email, relay, nothing). Called in the scan task on
 * every transition of an AL_NOTIFY alarm. what: 1 raised, 2 cleared, 3 acknowledged. */
enum { ALARM_TR_RAISE = 1, ALARM_TR_CLEAR = 2, ALARM_TR_ACK = 3 };
extern void (*alarm_on_change)(const alarm_def_t *d, uint8_t what);

/* For tests: forget every state (definitions stay). */
void alarm_reset_for_test(void);

#endif
