EnviroDevelo/cems-platform/platform/include/plat_clock.h

/* plat_clock.h - setting the instrument's clock (decision D22).
 *
 * The RTC keeps the site's local standard time (no daylight saving: a CEMS record
 * must not jump an hour twice a year). parameter 82 time_utc_offset (minutes) says how
 * far that is from UTC; it is used by the SNTP client and in email Date headers.
 *
 * Ways to set it, every one logged (LOG_EV_TIME_SET: old -> new, who, from where):
 *   touchscreen  System > Set clock (admin)
 *   web          "Set to this computer's time" or a typed time (admin)
 *   Modbus       write local seconds-since-1970 to parameter 85 clock_set (operator,
 *                REMOTE mode, as every PLC write): how a DAHS keeps the clock in step
 *   SNTP         from the site's time server (parameter 83 sntp_server, 0 = off),
 *                every sntp_interval minutes; only steps the clock when it is 2 s or
 *                more out, so the log is not filled with tiny corrections
 *
 * Threading: plat_clock_request() from any task; the scan task applies it (it owns
 * the RTC snapshot), so a set never tears a scan. */
#ifndef PLAT_CLOCK_H
#define PLAT_CLOCK_H
#include <stdint.h>
#include <stdbool.h>

#define PLAT_CLOCK_MIN_UNIX 1577836800u   /* 2020-01-01: anything earlier is refused */
#define PLAT_CLOCK_MAX_UNIX 4102444799u   /* 2099-12-31 23:59:59 */

/* Ask for the clock to be set to local_unix (local standard time as seconds since
 * 1970). how: a short word for the event log ("web", "sntp" ...). 0 = queued,
 * -1 out of range. */
int  plat_clock_request(uint32_t local_unix, uint8_t src, uint8_t level, const char *how);
void plat_clock_scan(void);                 /* scan task, pre_logic: applies a request */
bool plat_clock_now(uint32_t *local_unix);  /* any task: the clock as of the last scan; false = never set */
int32_t plat_clock_utc_offset_s(void);      /* parameter 82, in seconds */

/* SNTP client (platform/net/sntp.c), net task. */
typedef struct {
    uint32_t last_ok_ms;      /* uptime of the last good answer, 0 = none yet */
    int32_t  last_diff_s;     /* the clock was this far behind the server then (s; + = clock slow) */
    uint8_t  stratum;
    uint32_t tries, fails, steps;
    char     error[40];       /* the last failure, in words; "" if the last try worked */
} sntp_status_t;
void sntp_service(uint32_t now_ms);         /* net task, every few hundred ms; does a query when due */
void sntp_request_now(void);                /* query at the next service (web "Sync now") */
void sntp_status(sntp_status_t *s);
void sntp_reset_for_test(void);
extern uint16_t sntp_port;                  /* 123; tests use another */

#endif
