EnviroDevelo/cems-platform/platform/include/plat_sha256.h

/* plat_sha256.h - SHA-256 (FIPS 180-4), for password hashes. */
#ifndef PLAT_SHA256_H
#define PLAT_SHA256_H
#include <stdint.h>
#include <stddef.h>
typedef struct { uint32_t h[8]; uint64_t len; uint8_t buf[64]; size_t n; } sha256_t;
void sha256_init(sha256_t *s);
void sha256_update(sha256_t *s, const void *data, size_t len);
void sha256_final(sha256_t *s, uint8_t out[32]);
#endif
