EnviroDevelo/cems-platform/tests/integration/mail_test.py

#!/usr/bin/env python3
"""Alarm email end to end: build/netsim against a small SMTP server written here
(plain, STARTTLS and implicit TLS; RSA and ECDSA certificates made with openssl).

Checks: configuration over HTTPS, the test email, an alarm routed to email (and its
clear), batching, AUTH PLAIN over TLS, login refused without TLS, the certificate
fingerprint and pinning (a changed certificate is refused), retries then NOTIFY_FAIL,
the password never readable (web, backup file), the per-alarm action switch.

    python3 tests/integration/mail_test.py"""
import base64, hashlib, http.cookiejar, json, os, socket, ssl, subprocess, sys, tempfile, threading, time
import urllib.parse, urllib.request

ROOT = os.path.dirname(os.path.dirname(os.path.dirname(os.path.abspath(__file__))))
MB, WEB = 15602, 18602
BASE = f"https://127.0.0.1:{WEB}"
CTX = ssl._create_unverified_context()
TMP = tempfile.mkdtemp()
passed = failed = 0


def check(cond, what):
    global passed, failed
    if cond:
        passed += 1; print("  ok  ", what)
    else:
        failed += 1; print("  FAIL:", what)


def make_cert(name, kind):
    key, crt = os.path.join(TMP, name + ".key"), os.path.join(TMP, name + ".crt")
    alg = ["-newkey", "rsa:" + os.environ.get("RSA_BITS", "2048")] if kind == "rsa" else ["-newkey", "ec", "-pkeyopt", "ec_paramgen_curve:P-256"]
    subprocess.run(["openssl", "req", "-x509", "-nodes", *alg, "-keyout", key, "-out", crt, "-days", "30",
                    "-subj", "/CN=mail.site.local", "-sha384"], check=True, capture_output=True)
    der = ssl.PEM_cert_to_DER_cert(open(crt).read())
    fp = ":".join(f"{b:02X}" for b in hashlib.sha256(der).digest())
    return key, crt, fp


class Smtp:
    """mode: plain | starttls | tls. Records every message; can refuse logins."""
    def __init__(self, port, mode, cert=None, user="cems", password="Secr3t pw"):
        self.mode, self.cert, self.user, self.password = mode, cert, user, password
        self.msgs, self.auths, self.sessions = [], [], 0
        self.ls = socket.socket(); self.ls.setsockopt(socket.SOL_SOCKET, socket.SO_REUSEADDR, 1)
        self.ls.bind(("127.0.0.1", port)); self.ls.listen(5)
        threading.Thread(target=self.run, daemon=True).start()

    def ctx(self):
        c = ssl.SSLContext(ssl.PROTOCOL_TLS_SERVER); c.load_cert_chain(self.cert[1], self.cert[0]); return c

    def run(self):
        while True:
            try:
                c, _ = self.ls.accept()
            except OSError:
                return
            threading.Thread(target=self.session, args=(c,), daemon=True).start()

    def session(self, c):
        self.sessions += 1
        try:
            if self.mode == "tls":
                c = self.ctx().wrap_socket(c, server_side=True)
            f = c.makefile("rb")
            def send(s): c.sendall(s.encode() + b"\r\n")
            send("220 mail.site.local ESMTP test")
            secure = self.mode == "tls"
            mail = {"rcpt": []}
            while True:
                ln = f.readline()
                if not ln:
                    return
                ln = ln.decode().rstrip("\r\n")
                cmd = ln.split(" ")[0].upper()
                if cmd == "EHLO":
                    caps = ["250-mail.site.local"]
                    if self.mode == "starttls" and not secure:
                        caps.append("250-STARTTLS")
                    if secure:
                        caps.append("250-AUTH LOGIN PLAIN")
                    caps.append("250 8BITMIME")
                    c.sendall(("\r\n".join(caps) + "\r\n").encode())
                elif cmd == "STARTTLS":
                    send("220 go ahead")
                    c = self.ctx().wrap_socket(c, server_side=True); f = c.makefile("rb"); secure = True
                elif cmd == "AUTH":
                    parts = ln.split(" ")
                    if parts[1].upper() == "PLAIN":
                        _, u, p = base64.b64decode(parts[2]).decode().split("\0")
                        self.auths.append((u, p))
                        send("235 ok" if (u, p) == (self.user, self.password) else "535 5.7.8 Authentication credentials invalid")
                    else:
                        send("504 not here")
                elif cmd == "MAIL":
                    mail = {"from": ln[10:].strip("<>"), "rcpt": []}; send("250 ok")
                elif cmd == "RCPT":
                    mail["rcpt"].append(ln[8:].strip("<>")); send("250 ok")
                elif cmd == "DATA":
                    send("354 end with .")
                    body = []
                    while True:
                        l2 = f.readline().decode("utf-8")
                        if l2 in (".\r\n", ""):
                            break
                        body.append(l2[1:] if l2.startswith("..") else l2)
                    mail["data"] = "".join(body); mail["secure"] = secure
                    self.msgs.append(mail); send("250 queued")
                elif cmd == "QUIT":
                    send("221 bye"); return
                else:
                    send("502 ?")
        except Exception as e:
            print("   smtp server:", e)
        finally:
            try: c.close()
            except Exception: pass

    def close(self):
        self.ls.close()
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
