EnviroDevelo/cems-platform/(commit log)

2026-10-19 Core platform: scan engine, task skeleton, watchdog supervisor
    - PLC-style scan engine running the translated VM/MUX program: measured
    g_dt_ms, first-scan bit, per-scan RTC snapshot (UniLogic weekday),
    frozen input image, outputs default off, bounded external-write queue,
    seqlock snapshot publishing, execution statistics
    - Single definition of the UniLogic system tags (ul_system.h)
    - FreeRTOS task set with design-spec priorities, static allocation,
    weak service bodies, stack/malloc/assert hooks
    - Task monitor gating the IWDG; fault record kept across warm resets
    - BSP interface with PC simulation and STM32H5 HAL implementations
    - Host unit tests (161 checks), PC sim, FreeRTOS POSIX r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
2026-10-19 Shared parameter table, arbitration and FRAM parameter store
    - param: one validated table for touchscreen, web and Modbus (ID, level,
    local/remote mode, type, range, interlock), platform entries (mode,
    network, Modbus write enable, serial, store status), remote-link
    watchdog, per-scan shadow for readers
    - param_store: PF_PERSIST parameters plus retained blocks; factory and
    user regions with A/B copies, CRC-32 and sequence; records by ID with
    migration hook; fail-safe calibration-invalid handling; restore
    defaults keeps factory data; backup export/import with integrity checks
    - NVM interface with RAM simulation (power-cut injection) and SPI FRAM
    driver; store task; scan system h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
2026-10-19 I2C FRAM driver and 32 KB memory map for the MB85RC256V
    - nvm_fram_i2c.c: MB85RC series over HAL I2C, DMA (default), interrupt
    or polling, polling before the scheduler; A16 handling for 128 KB parts
    - Memory map chosen by PLAT_FRAM_SIZE: 32 KB default (dev part, 16%
    headroom against the old project's 342 retained tags), 128 KB option;
    static checks that the map does not overlap
    - bsp_param_nvm tries I2C, then SPI, then the RAM stand-in
    - Tests run with both maps; target link checked in five configurations
    Claude-Session: https://claude.ai/code/session_01Gwvd8bu485TQsBajzHm6x6
2026-10-19 Parameter blocks, batch writes, Modbus engine and Modbus TCP framing/server
    - Parameter table: text, UTF-16 text, raw bytes and arrays as entries, with
    reader copies, a block write queue, all-or-nothing batches, persistence
    - Scan applies every queued write before the logic (no split batches)
    - Modbus engine: FC 1/2/3/4/5/6/15/16/43-14 over a map of table entries,
    word/byte order, decimal scaling, strict all-or-nothing writes
    - Modbus TCP: MBAP framing with partial/pipelined frames, socket server
    with client limit, eviction of the longest-silent client, IP filter
    - 1,401 host checks
    Claude-Session: https://claude.ai/code/session_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
2026-10-19 Modbus TCP, web interface and lwIP networking
    - Modbus engine over the parameter table (all shapes of the old slave map),
    MBAP framing, socket server with client limit, eviction and IP filter
    - Web: JSON API, page with live polling and connection-lost banner, logins
    with salted SHA-256 passwords in FRAM, sessions with write re-auth,
    CSRF header, backup/restore through a store-task mailbox
    - Parameter blocks, all-or-nothing batches, scan applies the whole queue
    - lwIP 2.2.1 on FreeRTOS: lwipopts, ST H5 Ethernet driver ported to native
    FreeRTOS (SLA0044), net task with per-unit MAC and live address changes
    - Tests: 2,191 unit checks; netsim on real sockets with pymodbus and HTTP
    (49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
2026-10-19 Event log and data logger on serial NOR, CSV export, web event list
    - plat_log: two rings (events, data) of CRC-protected 64-byte slots, erase-ahead
    overwrite-oldest, FRAM write pointer with flash rebuild, interval means with
    quality codes, schema records, clock-change and parameter-change events
    - nor.h with RAM simulation (power-cut injection) and a JEDEC SPI NOR driver
    - log_csv: streaming CSV for events and data; /api/log/* endpoints; login,
    password, restore and logout events from the web API
    - platform parameters 30 (log_interval) and 61 (log_status)
    - tests: unit (incl. random power-cut fuzz), netsim integration, browser
    C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
2026-10-19 Firmware update foundation: streamed upload, bank swap, trial boot, rollback
    - fw_update: .cfw image header (product, version, SHA-256, signature hook),
    streaming upload into the free bank with read-back verification, staged image
    in a trailer sector, FRAM boot record (pending/trial/rolled back), automatic
    confirm after a healthy trial, rollback on a reset during the trial
    - STM32H5 dual-bank flash driver (SWAP_BANK) and a RAM simulation
    - HTTP: streamed POST /api/fw/upload, GET /api/fw, POST /api/fw/activate;
    firmware section on the admin page with upload progress
    - tools/mkfwimage.py; unit tests, end-to-end netsim test with swap/reset,
    browser test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
2026-10-19 EVE BT817 display driver and the touch UI
    - eve: SPI framing, BT817 start-up with the Riverdi RVT70 timing, co-processor
    command lists (text, buttons, keys, numbers, progress, rectangles, lines),
    touch tags, co-processor fault recovery, buffer overflow guard
    - ui: home tiles and local/remote control, paged settings with the reason a row
    can't be changed, numeric/IP/on-off/text entry through the parameter table,
    log in with lockout and idle logout, events, system (firmware restart with
    confirmation, network, unit, storage, brightness), confirm dialogs, dimming
    - UI task with display retry; firmware trial health includes the display;
    STM32H5 SPI transport; app supplies home tiles;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
2026-10-19 Duplicate-address check (ARP probe), IP CONFLICT alarm; HTTPS and remote-access design (D11, D17)
    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
2026-10-19 HTTPS (D11): unit key and self-signed certificate, TLS 1.2 server, redirect; memory record (D18)
    - tls: P-256 key made at first start, kept in FRAM META (two copies, never in
    backups); deterministic self-signed certificate with the unit's IP; session
    tickets; fixed 36 KB mbedTLS pool; fingerprint on the touchscreen and web page;
    certificate download to trust the unit; new-key event
    - web server: HTTPS on 443, port 80 redirect only (parameter 6), refused
    uploads drained so clients get the answer
    - mbedTLS 3.6.7 LTS subset vendored in third_party/mbedtls (Apache-2.0)
    - tools/mem_report.py and docs/MEMORY.md: flash/RAM by module from the linker
    map, run by tools/check_target.sh
    - test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
2026-10-19 Firmware image signing (D14): ECDSA P-256, key tool, dev-build notice
    - fw_sig.c verifies r||s over SHA-256(header 0..83) with mbedTLS; fw_pubkey.c
    (generated by tools/fwkey.py) holds the product key; with a key, unsigned or
    wrongly signed images are refused
    - mkfwimage.py --key signs the header as sent (flags=1); --check --pub verifies
    - /api/fw signing_required; web page and System screen show the dev-build notice
    - tests: unit (keys made in test: accept, unsigned/other-key/edited refused),
    fw_test signed flow via netsim CEMS_FW_PUBKEY (30 checks)
    - *.pem ignored so the private key can't be committed; docs and MEMORY.md updated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
2026-10-19 Alarm actions per alarm (email, Modbus, relays, nothing) and alarm email
    - per-alarm actions (parameter 46, user choice over the application default):
    email, Modbus common-alarm word (45), alarm relays 1-4 on any digital output
    with active / horn / lamp modes and fail-safe (47-49), via a scan io_out hook
    - alarm email: SMTP to the site mail server by IP, STARTTLS / TLS / plain,
    login only over TLS, server certificate pinning (test email shows the
    fingerprint, trust stores it), batching, retries, NOTIFY_FAIL, event log;
    runs in the web task and shares its TLS context and pool (44 KB)
    - mbedTLS: TLS client, RSA, SHA-384/512, base64, keep peer certificate
    - PF_SECRET / RF_SECRET: the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
2026-10-20 Clock: set from touchscreen, web, PLC or the site's SNTP server; every change logged once
    - plat_clock: requests from any task applied by the scan (bsp_rtc_write on H5,
    host, netsim, rtos sim); range 2020-2099; weekday computed; logged with source
    and level; the logger no longer reports the same step as an unexplained jump
    - parameters 82 UTC offset, 83 SNTP server, 84 interval, 85 clock_set (momentary,
    PLC/DAHS), 86 clock_unix (RO)
    - SNTP v4 client: echo check, unsynchronised servers ignored, steps only when
    2 s out, retry after 60 s; runs in the net task (netsim: own thread)
    - web: Clock section (set to this computer, typed time, SNTP set-up, Sync now);
    touchscreen: System > Set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
2026-10-20 Own touchscreen fonts (° ² ³ µ ...), health monitoring, soak test
    Fonts (D24): tools/mkfont.py renders DejaVu Sans at the ROM font sizes as EVE L4
    fonts with ASCII and 31 symbols in codes 1..31; kept zlib-compressed in the
    firmware (24 KB), inflated into RAM_G at start-up (CMD_INFLATE) and checked with
    CMD_MEMCRC; a font that fails falls back to the ROM font. The UI encodes UTF-8
    for them (eve_font_encode). Simulator: CMD_INFLATE with its own zlib decoder,
    CMD_MEMCRC answered in the FIFO, RAM_G; preview tool draws the symbols.
    Health: the supervisor samples heap (free, worst) and every task's stack margin
    every 5 s; /api/info health, System screen, alarm 11 RESOURCE_LOW (latched).
    tests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
2026-10-20 docs: HARDWARE.md schematic list (RTC VBAT + LSE added) and DK bring-up checks; FRAM size deferred
    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
2026-10-22 I/O boards on RS-485 (D27): Modbus RTU master, channel image to 64 with fault bits, alarms, events, screens; simulated I/O node
    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
2026-10-22 Memory record with the I/O bus and app_vmmux; I/O boards as their own module in the report
    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
2026-10-22 I/O boards: input filter default 8 ms (as the old panel and the design spec)
    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
2026-10-22 I/O boards: the node holds its outputs for a set time (default 5 min, up to 10) when the link goes quiet; 'not responding' stays at 1 s
    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
2026-10-22 I/O boards: latched comms fault at both ends (IOB_LOST latched; node COMMS_LOST cleared only after acknowledge); every input change shown to the master
    iobus.h: STATUS bit 8 COMMS_LOST, FAULT_CLEAR bits (1 events, 2 comms), INPUTS change hold.
    iobus.c: IOB_LOST also raised by a board's COMMS_LOST; FAULT_CLEAR bit 1 sent only once
    IOB_LOST is acknowledged; events and a fault line. plat_alarm.c: IOB_LOST AL_LATCH.
    iob_node_sim.c: the same behaviour as the node firmware. Tests: t_comms_latch, t_input_pulse.
    Claude-Session: https://claude.ai/code/session_01NqyuUAraePKPtYTAPTmWUU
2026-10-22 iobus.h: I/O board address handshake (registers 40-51, iob_cfg_check), commissioning address 246, serial number registers 52-59; simulated node follows; t_node_cfg
    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
2026-10-22 iobus.h: the I/O board address change is one guarded FC16 write of 40-42 (key 0xA55A, address, complement); handshake removed; simulated node follows
    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
2026-10-24 I/O boards: address setting 1..245 (246 and 247 are the commissioning and USB addresses)
    iobN_address allowed 1..247, but a node answers on RS-485 only at 1..IOB_ADDR_MAX;
    246 is where a board without an address answers (reads and the address change only)
    and 247 is its USB port. A board set to either never ran. The parameter range and
    bad_settings() now stop at IOB_ADDR_MAX; t_wrong_type_and_conflicts checks both.
    Claude-Session: https://claude.ai/code/session_018PtUXH3akFPqQfzHC3CnCM
2026-10-24 I/O boards: find a new board and set its address from the web page
    A new I/O board answers only at 246 until it has an address. Administration ->
    I/O board addresses (admin login) finds it, shows its serial, chip ID and
    firmware, and gives it an address with the guarded FC16 of 40-42 (FW-61). The
    master refuses an address something already answers at, and reads the board
    back at the new address before reporting success; the change is logged.
    - iobus.c: iob_cm_find / iob_cm_assign, done by the bus task between cycles
    - http_api.c: POST /api/iob/find, POST /api/iob/assign, GET /api/iob/commission
    - web/index.html (+ web_page.c regenerated)
    - tests: t_commission, the HTTP routes, iob_test.py c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
2026-10-24 I/O boards on Ethernet: Modbus TCP master and discovery commissioning (D27 revised)
    The I/O bus master can now run over Ethernet (parameter 102 iob_link, default Ethernet)
    with RS-485 kept as an option. Frames stay RTU inside the master; iob_net.c converts to
    and from Modbus TCP (unit id = board address), so every rule of the register map holds.
    Each board has an IP setting (iobN_ip). A UDP discovery protocol (FIND/HERE/SET, port
    50223) lists the boards on the network and gives a board its IP and address; a board
    that has a supervisor IP accepts settings and Modbus TCP only from that supervisor.
    Tests run the bus suite on both links against simulated boards, plus the codec,
    Ethernet commiss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
2026-10-24 I/O boards on Ethernet: socket transport (Modbus TCP client, UDP discovery)
    iob_tcp.c gives the master its Ethernet port over plat_net.h sockets (POSIX on the PC,
    lwIP on the H5): one connection per board, opened on first use, a connect timeout,
    late replies dropped by transaction id, a connection that sends garbage closed and
    reopened. Discovery broadcasts to IOB_DISC_PORT from an ephemeral port; the boards
    answer to the broadcast address at that port.
    Wired into plat_start (FreeRTOS) and netsim (simulated boards on a simulated network,
    or real boards with CEMS_IOB_TCP=1). Tested over the loopback against a simulated board
    in a child process. lwIP pools and the iobus stack grown to fit.
    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
2026-10-24 I/O boards on Ethernet: commissioning from the HTTPS page
    GET /api/iob/net lists the boards found on the network (identity, MAC, IP settings,
    which board slot they match); POST /api/iob/net/find broadcasts a search and
    POST /api/iob/net/set gives a board a slot's IP and Modbus address with the
    supervisor's own fixed IP, mask and gateway (refused with DHCP on). The admin page shows
    the Ethernet panel or the RS-485 address panel, whichever link is in use.
    netsim gets 'node n new' (a replacement board with no IP and no address); the
    integration test commissions a board over Ethernet from the page, then switches the
    link to RS-485 and runs the address commissioning there (43 checks).
    Co-Author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
2026-10-24 netsim: CEMS_IOB_TCP_HOST, to run against a virtual I/O board on the PC
    Connects every board connection to one address (io-node's build/vnode_net on 127.0.0.1),
    since the PC has none of the plant's addresses. Used by io-node's net_e2e.py.
    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
2026-10-24 Docs: I/O boards on Ethernet (D27 revised 24 Oct)
    D27, PLATFORM.md 5k (the link, IP commissioning, settings), HARDWARE.md H11 (Ethernet
    replaces RS-485; RS-485 optional), CUBEMX_SETUP 3g and APP_INTEGRATION.
    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
2026-10-25 I/O boards: temperature inputs and pump PWM (register map 2)
    From the review of the legacy dryer slave. The master accepts map 1
    and map 2 boards; on map 2 it writes the PWM with the outputs, reads
    the larger status block, reads temperatures every 500 ms when a sensor
    is configured, sends sensor type/NTC/PWM settings on change, applies
    per-channel offset and span, and fills the platform's RTD channels.
    - iobus.h/iobus.c: map 2 registers, types, states, iob_temp_cal.
    - New alarm IOB_TEMP_FAULT (18) and status bit; parameters 160+16k.
    - Web: temperature table and pump line per board, admin "Set to..."
    zero against a reference (POST /api/iob/temp/zero).
    - Simulated node implements map 2; tes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
2026-10-25 CPU fault handlers (D4) and docs catch-up for the Ethernet I/O boards
    HardFault, MemManage, BusFault and UsageFault now go to
    port/stm32h5/fault_stm32h5.c: outputs to the safe state, the stacked PC and
    LR plus CFSR, HFSR and the faulting address into plat_diag, then a reset.
    The next boot shows the fault as "bus @0801A2C4" on the System screen, the
    web page and the event log's power-up entry; /api/info last_fault gains
    arg, lr, cfsr, hfsr and addr. A stack-limit fault is named "stack" with no
    PC, since its frame is not usable.
    Docs: D4 marked built; CubeMX must not generate the four fault handlers;
    the iobus task row, the memory report label and APP_INTEGRATION's D6 line
    brought up to date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
2026-10-25 HARDWARE.md: second RJ45 for the Ethernet I/O board via a 3-port switch IC (proposed)
    Claude-Session: https://claude.ai/code/session_014onnq3eRiDkqdAB6fKiRDW
2026-10-25 Touchscreen I/O boards screen: board IP on Ethernet, temperatures and pump
    Since D27 the boards are reached by IP; the screen showed only the Modbus
    address. Each board card now shows its IP and address on Ethernet (or
    "RS-485, address N"), the channel ranges on the Outputs/Inputs headings,
    the configured temperature channels (calibrated, as on the web page; a
    faulty channel says "fault" with the reason in the fault lines) and the
    pump duty and speed (register map 2). Integer formatting, no float printf.
    Docs: H4 records the display plugged straight onto the core PCB (Gary,
    25 Oct), the RiBUS pinout with the 5 V backlight supply, and the ILI2132A
    touch controller; screenshots regenerated.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
2026-10-25 Generous stack and heap sizes; name the task on a stack-limit fault
    Gary, 25 Oct: stack overflows on earlier DK prototypes, so size for
    headroom from the start. Task stacks doubled (85 KB in all, each still
    overridable), idle and timer stacks doubled, FreeRTOS heap 48 -> 64 KB,
    main stack 1 -> 8 KB and C heap 0.5 -> 4 KB in the linker settings
    (CUBEMX_SETUP.md section 1, and the link check uses the same values).
    RAM: 73 % for the platform, about 80 % with the VM/MUX application.
    The CM33 port gives every task a PSPLIM, so an overflow is a UsageFault
    with STKOF before anything is corrupted; the fault handler now records the
    running task, shown as "stk scan".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
2026-10-25 HARDWARE.md: W5500 I/O port pin and socket notes from the firmware thread
    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
2026-10-25 Web page: I/O board card shows the board's IP, as the touchscreen does
    "192.168.1.61, address 1" on Ethernet, "RS-485, address 1" otherwise,
    "No IP set (iobN_ip)" when blank; from iob_link and iobN_ip in the value
    poll. iob_test.py checks the card text.
    Claude-Session: https://claude.ai/code/session_01EABSPFqJyWXzEHYMFCKdZS
2026-10-25 Web page: fits a phone's width
    Below 640 px the parameter and alarm lists stack into cards, wide tables
    scroll inside their own section, and the certificate fingerprint wraps,
    so the page no longer scrolls sideways (it was 600 px wide in a 390 px
    window). Trend axes pick their tick spacing and decimals from the space
    and range. web_ui_test.py checks the page width at 390 px.
    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
2026-10-25 docs: core PCB design spec (pin map, power, connectors, display FFC from the RVT70 datasheet); two-network Ethernet decided
    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
2026-10-25 I/O boards on their own network: W5500 I/O port
    The I/O boards now sit on a separate Ethernet port (W5500 on SPI) so the
    client/plant network never carries board traffic. Portable W5500 driver,
    an iob_port/iob_dgram transport over it, a simulated chip for host tests
    and netsim, STM32H5 SPI glue, and settings 103-105 (I/O port IP, prefix,
    status). /api/iob/net gains a "port" field; the link string is unchanged.
    Claude-Session: https://claude.ai/code/session_01YTthWNuUHnod3MeXnY4G3N
2026-10-25 CORE_PCB.md: W5500 labels match the firmware (W5500_CS, W5500_RST); crystal and SPI trace notes
    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
2026-10-25 I/O boards screen: show the board IP on any IP link, not only iob_link 1
    PR #3 adds iob_link 2 (the W5500 I/O port); boards there are reached by IP too.
    Claude-Session: https://claude.ai/code/session_01AbDXgecyAmn6R8hhL7qjD2
2026-10-25 Web page: I/O board card treats any Ethernet link as Ethernet
    iob_link gains 2 (the separate I/O port) in PR #3; show the board IP for
    every non-zero link, not only 1.
    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
2026-10-25 Web server: several browsers at once get their polls on time
    Accepted connections now wait in a table of 3 (plus the kept connection:
    the 4 HTTP sockets in the lwIP budget) with no TLS until their first
    bytes arrive; a connection silent for 2 s is closed, and one closed
    unused is dropped quietly. Before, the server served each accepted
    socket at once, and the spare sockets browsers open and never use held
    it for the 2 s read timeout each: 4 browsers got one value poll every
    5-8 s. The kept connection is now dropped only when another connection
    has actually spoken. The port-80 redirect is polled with no wait, so it
    no longer adds 50 ms to every HTTPS request (H5 task and netsim).
    Silent firs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
2026-10-25 CORE_PCB.md: Gary's answers (24 VDC, DIN rail behind the display, no system-OK relay); FFC length notes
    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
2026-10-25 docs: no RS-485 on the core board; RJ45s with integrated magnetics (Gary)
    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
2026-10-25 Web server: Content-Security-Policy and Referrer-Policy on the page
    The page may load scripts, styles and data only from the unit, may not
    be framed, and sends no referrer. no-store, nosniff and frame-deny were
    already on every reply. HSTS is left out (ignored for IP hosts and
    click-through certificates).
    test_http.c checks the headers on the page and their absence on JSON;
    web_ui_test.py loads the phone-width page under the policy and fails on
    any violation (its main page bypasses CSP because wait_for_function
    evaluates strings). The trend CSV download works under the policy.
    Claude-Session: https://claude.ai/code/sessio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
2026-10-25 Refuse an I/O link the board has no port for
    The CORE PCB has no RS-485 transceiver, so setting iob_link to RS-485 there
    would leave every board "not responding". Setting 102 now has an interlock
    that refuses a link whose port was never registered.
    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
2026-10-25 Log in screen: Enter and Cancel as large as the card allows
    They were 40 px tall (about 6 mm on the RVT70), the smallest touch target on
    any screen; now 112 px, beside the level buttons.
    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
2026-10-25 Web page: plain message for an interlock refusal; slow-link measurements
    A write refused with "interlock" (e.g. iob_link to RS-485 on a board
    without the port, PR #3) now reads "Not possible on this unit, or
    blocked by another setting". PLATFORM.md records the page over emulated
    VPN/cellular links (RTT 100 ms to 1.2 s): updates slow down, the page
    never shows connection lost.
    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
2026-10-25 Core PCB: KiCad 7 schematic (5 sheets, 145 parts) generated from design data and checked against KiCad's netlist; enclosure choice; spec updates
    - hardware/core_pcb: project, sheets, PDF, BOM; tools/design.py is the circuit as data,
    gen_schematic.py writes the sheets, check_netlist.py proves KiCad's netlist matches it
    - CORE_PCB.md: TPS54360 5 V buck, Schottky reverse protection, SMBJ33CA, Wurth MagJacks,
    Hirose FFC; enclosure shortlist with Phoenix Contact BC 107,6 chosen (overridable)
    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
2026-10-26 docs: Common Instrument Platform Specification (draft)
    Gary's 26-item baseline and three principles as requirements, each marked
    mandatory, optional by product or service-only, and checked against the
    CORE platform as done, partial or missing. Includes what updates and resets
    keep, a proposed state model, decisions for Gary and gaps by owning thread.
    Claude-Session: https://claude.ai/code/session_01QtCks9RFvNLBAATjb4Fv5i
2026-10-26 Core PCB: close the platform spec's gaps (CIP-01.3, 07.3, 24, 04.4/20.4)
    - CORE_PCB.md 12: hardware revision strap encoding (PE7/PE8) and 24 V sense scaling (PC0)
    - CORE_PCB.md 13: debug lock (Closed with debug authentication) and SWD recovery route
    - CORE_PCB_EMC.md: IEC 61326-1 industrial immunity levels, CISPR 11 class A, environment, IP
    - Schematic: 24 V input gets a common-mode choke (L3), Y-capacitors (C16, C17) and a 3 kW
    TVS (SMDJ33CA) for the IEC 61000-4-4/-5 levels; netlist check passes (148 parts)
    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
2026-10-26 Record editor and text keyboard: buttons at least 56 px (UI_CONVENTIONS 6)
    Record editor header: Save, Cancel, - and + 56 px tall (were 48). Text
    keyboard: OK and Cancel 144 px tall beside the narrowed card (were 48).
    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
2026-10-26 CORE_PCB.md 13: debug lock agreed with the firmware thread (identity in FRAM survives regression; Closed-state bank swap to prove on the DK)
    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
2026-10-26 Web page: instrument state, value quality, link indicator, diagnostic package
    CIP-21.2/21.4/21.5: the header shows the instrument state and LINK OK /
    LINK LOST / NO LINK; a value whose quality is not valid is greyed with
    its word (colours and words from docs/UI_CONVENTIONS.md, "----" when
    unavailable), on the parameter rows, tiles and trend legend; trend lines
    break at non-valid samples and the CSV gains a quality column. Reads the
    fields agreed with the firmware thread ("state" in /api/info, sparse "q"
    in /api/values keyed "id" or "id.index") when present.
    CIP-22.1: "Diagnostic package" in the Event log section downloads one
    JSON file assembled in the browser from existing endpoints, secre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
2026-10-26 Reboot-loop detection and safe mode (CIP-08.5)
    Three crashes (watchdog, or a software reset after a recorded fault) with
    less than 10 minutes of running between them start the unit in SAFE_MODE:
    no application code at all, outputs off, network, web, Modbus, touchscreen
    and firmware update still running, and platform alarm 19 SAFE_MODE raised.
    A power cycle, a clean restart or a full-window run clears it.
    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
2026-10-26 Supply monitoring and power-fail write hold (CIP-07.3, CIP-07.5)
    The ctrl task reads the 24 V supply sense (PC0, ADC1 with VREFINT) every ms
    into a 16-reading average: parameter 305, alarm 20 SUPPLY outside 19-30 V,
    and below 16 V the store task starts no new FRAM or log-flash write after
    the power_fail event, resuming after a second back above 18 V.
    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
2026-10-26 Core PCB: 24 V hold-up (2 x 470 uF 63 V) for the firmware's 20 ms power-fail window; fuse to 2 A T
    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
2026-10-26 CORE_PCB.md 5a: correct the 24-16 V hold-up figure (28 ms)
    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
2026-10-26 System screen: the 24 V supply reading (CIP-07.3, parameter 305 via plat_supply_mv)
    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
2026-10-26 System screen: clock as dd/mm/yyyy hh:mm so it clears the Set clock button
    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
2026-10-26 CORE_PCB.md 5a: record the firmware's power-fail response (2 ms trip, backlight off)
    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
2026-10-26 UI task: backlight off and no display traffic while the supply is failing (CIP-07.5)
    The hold-up from 16 V is about 20 ms at full load and 42 ms with the
    backlight off (CORE_PCB.md 5a). The task checks plat_power_failing() at
    the top of every loop, before each frame and every 2 ms of its 20 ms
    wait: on failing it writes REG_PWM_DUTY 0 and stops sending; on restore
    the backlight is set again and the kept frame shows at once.
    Not built for the target here (no ARM toolchain or FreeRTOS checkout);
    syntax-checked with -Wall -Wextra -Wconversion against stub RTOS headers.
    Claude-Session: https://claude.ai/code/session_01AbDXgec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
2026-10-26 Platform Modbus block: identity, heartbeat, link age, versions (CIP-01.6, 14.4, 15)
    Input registers 9000-9083 (9000-9199 reserved) carry the same block in every
    product: block and map versions, a 100 ms heartbeat, state, seconds since
    the last supervisory request, alarms, hardware revision, serial, firmware
    and API versions, uptime, supply, measurement quality and identity text.
    An application entry in that range stops the start-up. The power-fail
    check now trips on two raw supply readings below 16 V instead of the
    16-reading average (the board's hold-up time is about 20 ms).
    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
2026-10-26 Core PCB: save datasheets and clear the datasheet checks
    Add hardware/datasheets with the six datasheets Gary supplied and an index.
    Apply what they show: TPS54360B with 22 uH and compensation from its
    datasheet, LAN8742A crystal caps 33 pF, W5500 reserved pins 38-42 left open
    and its reference crystal circuit (1M, 0R), FRAM and choke checks cleared.
    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
2026-10-26 Calibration records with factory/field split, history and due dates (CIP-18)
    plat_cal.c keeps, per calibrated channel, the factory record and the record
    in force, plus the last 12 records of any outcome, in the FRAM factory region
    (survives firmware updates and restore defaults). Begin/accept/abort/revert go
    through parameter 320, so mode and level rules apply; setting 321 sets the
    login level that may calibrate (CIP-19.3). The product declares its channels
    (coefficient parameters, interval, check hook) and runs the procedure; the
    platform enforces all-or-nothing coefficient writes, the CALIBRATION state, a
    2 h timeout, event log entries (CIP-17.6) and alarm 21 CAL_DUE. GET/POST
    /api/cal for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
2026-10-26 Web page: Calibration section (CIP-18)
    Channels with the record in force, the factory record and the due date
    (overdue marked); Begin, Revert to factory (factory login), and Accept /
    Abort while a channel is calibrating; history with outcome, source and
    level, points and coefficients. Uses GET/POST /api/cal; refusals show
    the instrument's reason. Polls every 3 s, every 1 s while calibrating.
    tests/integration/cal_web_test.py: refused in LOCAL, a factory
    calibration accepted (CALIBRATION in the header, record in force,
    history), and one aborted.
    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
2026-10-26 Touchscreen calibration screen (CIP-18): channels, record in force, points, history; start/accept/abort/revert with refusals in words
    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
2026-10-26 Clock quality: synchronised, last sync, source (CIP-02.6); per-channel overdue on /api/cal
    Parameters 316-318, Modbus block layout 2 (9084-9089, added after the
    existing registers), /api/time synced/sync_time/source. An SNTP answer
    confirms the clock even when no step is needed. /api/cal channels gain
    "overdue" for the web page (HTTPS thread request).
    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
2026-10-26 Web page: clock quality on the Clock panel (CIP-02.6)
    SYNCHRONISED / NOT SYNCHRONISED with when and from where the clock was
    last set or confirmed, from /api/time synced, sync_time and source.
    The calibration table now uses each channel's "overdue" from /api/cal.
    web_ui_test.py checks the clock shows synchronised from the web page
    after "Set to this computer's time".
    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
2026-10-26 System screen: show when the clock is not synchronised (CIP-02.6); tighten storage rows so Memory stays inside the card
    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
2026-10-26 Board revision straps, build ID, image header v2 with board range (CIP-01.3, 03.2, 25.1)
    Merges the base branch (core PCB PR #5, platform spec PR #7).
    bsp_hw_straps reads PE7/PE8 (labels HW_REV0/HW_REV1) once at start: parameter
    319 board_rev, /api/info board_rev, alarm 22 HW_REV when it disagrees with the
    factory hw_rev. Image header version 2 adds the board revision range, settings
    layout version and build ID, all signed; images for other boards are refused
    at upload and at activation. PLAT_BUILD_ID (git short hash) on /api/info and
    /api/fw. mkfwimage.py writes v2 (--hw, --layout, --build-id).
    Claude-Session: https://cl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
2026-10-26 Web page: build ID and board revision in the header and Firmware panel
    From /api/info board_rev and build, and /api/fw build, staged_build and
    staged_hw (shown only when the image is limited to some revisions).
    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
2026-10-26 Service history: operating hours, service log, test record, config checksum (CIP-22.2, 22.4, 23.4, 05.4)
    plat_service.c keeps powered hours and hours since service (0.1 h steps), the
    last 8 service log entries and the manufacturing test record in the FRAM
    factory region, flagged RF_UNIT so a backup restored into another unit never
    copies them. A CRC-32 over the user settings is worked out every second.
    Parameters 330-332; /api/info run_hours and config_crc; GET /api/service and
    POST /api/service/log and /api/service/test at factory login. The store now
    collects platform blocks from a list of providers.
    Claude-Session: http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
2026-10-26 System screen: build ID, board revision, operating hours and hours since service, configuration checksum (CIP-05.4)
    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
2026-10-26 Passwords: PBKDF2 storage, 8-character admin/factory passwords, recovery by developer token (CIP-19.3, 20.3)
    Passwords are stored as PBKDF2-HMAC-SHA256 (4096 rounds, checked against
    Python's hashlib); a hash from older firmware still works and is re-stored at
    its next good login. New admin and factory passwords need 8 characters; the
    operator PIN stays at 4. A token signed by the developer key over the chip ID
    and the unit's reset count (factory region, one-time) puts all passwords back
    to the defaults: GET/POST /api/auth/reset (no login; a wrong token counts as a
    failed login), tools/reset_token.py. plat_dev_token_ok() shared with the
    serial number.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
2026-10-26 Passwords: 4 characters minimum at every level
    The owner confirmed 4-character passwords are fine, so admin and factory
    go back to the same AUTH_PW_MIN as the operator PIN. PBKDF2 storage and
    token recovery are unchanged.
    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
2026-10-26 Web page: Lost passwords panel (developer reset token, CIP-19.3)
    The login row gets a "Lost passwords?" panel for GET/POST /api/auth/reset:
    it shows the line to send the developer, takes the token (checked as 128
    hex digits on the page), and reports refused, locked or no-key answers.
    New tests/integration/reset_web_test.py (13 checks) runs the whole flow
    with tools/reset_token.py, including a token that only works once.
    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
2026-10-26 Start-up self-test list (CIP-11.1)
    plat_selftest runs a fixed list after every start, one pass/fail/skip
    result each: running image against its bank header (fw_running_check,
    hashed 16 KB per store-task pass), March C- RAM block, RTC running,
    settings FRAM, calibration, log flash, plant-port PHY and I/O-port
    W5500 (reported by their drivers), display, plus up to 8 product checks
    from plat_app_t.selftests. Results: parameter 333 (failed bits), one
    selftest event, /api/info "selftest", and alarm 23 SELFTEST for
    failures with no alarm of their own.
    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
2026-10-26 Published fault and alarm code list (CIP-11.3)
    docs/FAULT_CODES.md is written by tools/fault_codes.c from the firmware's
    own tables: platform alarms with a new .help (what to check), self-test
    bits, fault record codes, reset causes, event codes, firmware update
    refusals. make fault-codes regenerates it (and a product's own list with
    APP=); make test fails if it is stale or a platform alarm has no help.
    Also: event labels for state/power/service/cal, plat_fault_text(), and a
    demo product self-test.
    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
2026-10-26 Web page: start-up self-test in the Service section (CIP-11.1)
    One badge per check from /api/info "selftest" (pass, fail, not checked,
    pending) and a summary naming any failed check, visible without a login.
    cal_web_test.py checks it on a blank unit (calibration fails), 12 checks.
    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
2026-10-26 Interface snapshots, make conformance, product profile (spec 9.2, 9.3)
    - tools/modbus_map.c writes a build's Modbus register map from its tables
    (docs/interface/app_demo/MODBUS_MAP.md); make test fails if it no
    longer matches (CIP-14.4, 14.5). mb_entry_count/mb_entry_at added.
    - tools/api_snapshot.py records every web route and JSON field with its
    type, and the parameter table, from a running netsim (API.txt).
    - make conformance APP=<dir>: contract, PROFILE.md filled in, help on
    every alarm, snapshots current, and tests/integration/conformance_test.py
    (start-up, power cut, corrupted settings, comms loss, update failure)
    against the product's own build. The demo passes.
    - docs/PRO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
2026-10-29 Web page: tabs instead of one long page
    Sections are grouped into tabs (Overview, Trends, Settings, Calibration,
    Service, I/O boards, Event log, Administration, Alarm setup) on a sticky
    tab bar that scrolls sideways on a phone. A tab shows when one of its
    sections does, so logins and the firmware decide as before. The open tab
    is kept in the address (#service) and survives a reload; one that needs
    a login opens once the login shows it. Closed tabs poll at most every
    30 s and a tab polls at once when opened; values, alarms and info poll
    on every tab. Both I/O board set-up panels start hidden until the link
    type is known (no flash of the wrong one).
    Browser tests switch tabs; request_queue_te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
